charitywater/india-mark-ii-sensor/Firmware/ssm/doc/CapTIvate Harness.png

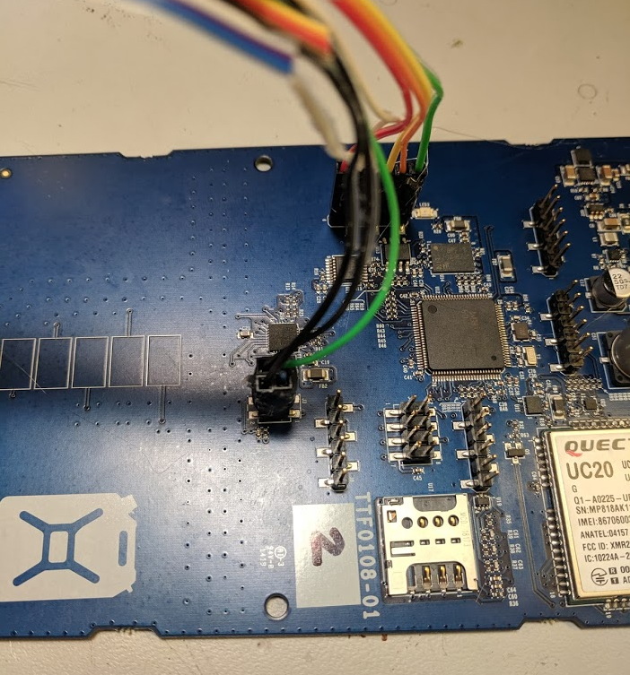
Firmware/ssm/doc/CapTIvate Harness.png
