charitywater/india-mark-ii-sensor/Mechanical/TT10723_ASM_SENSOR_REV-D.PDF

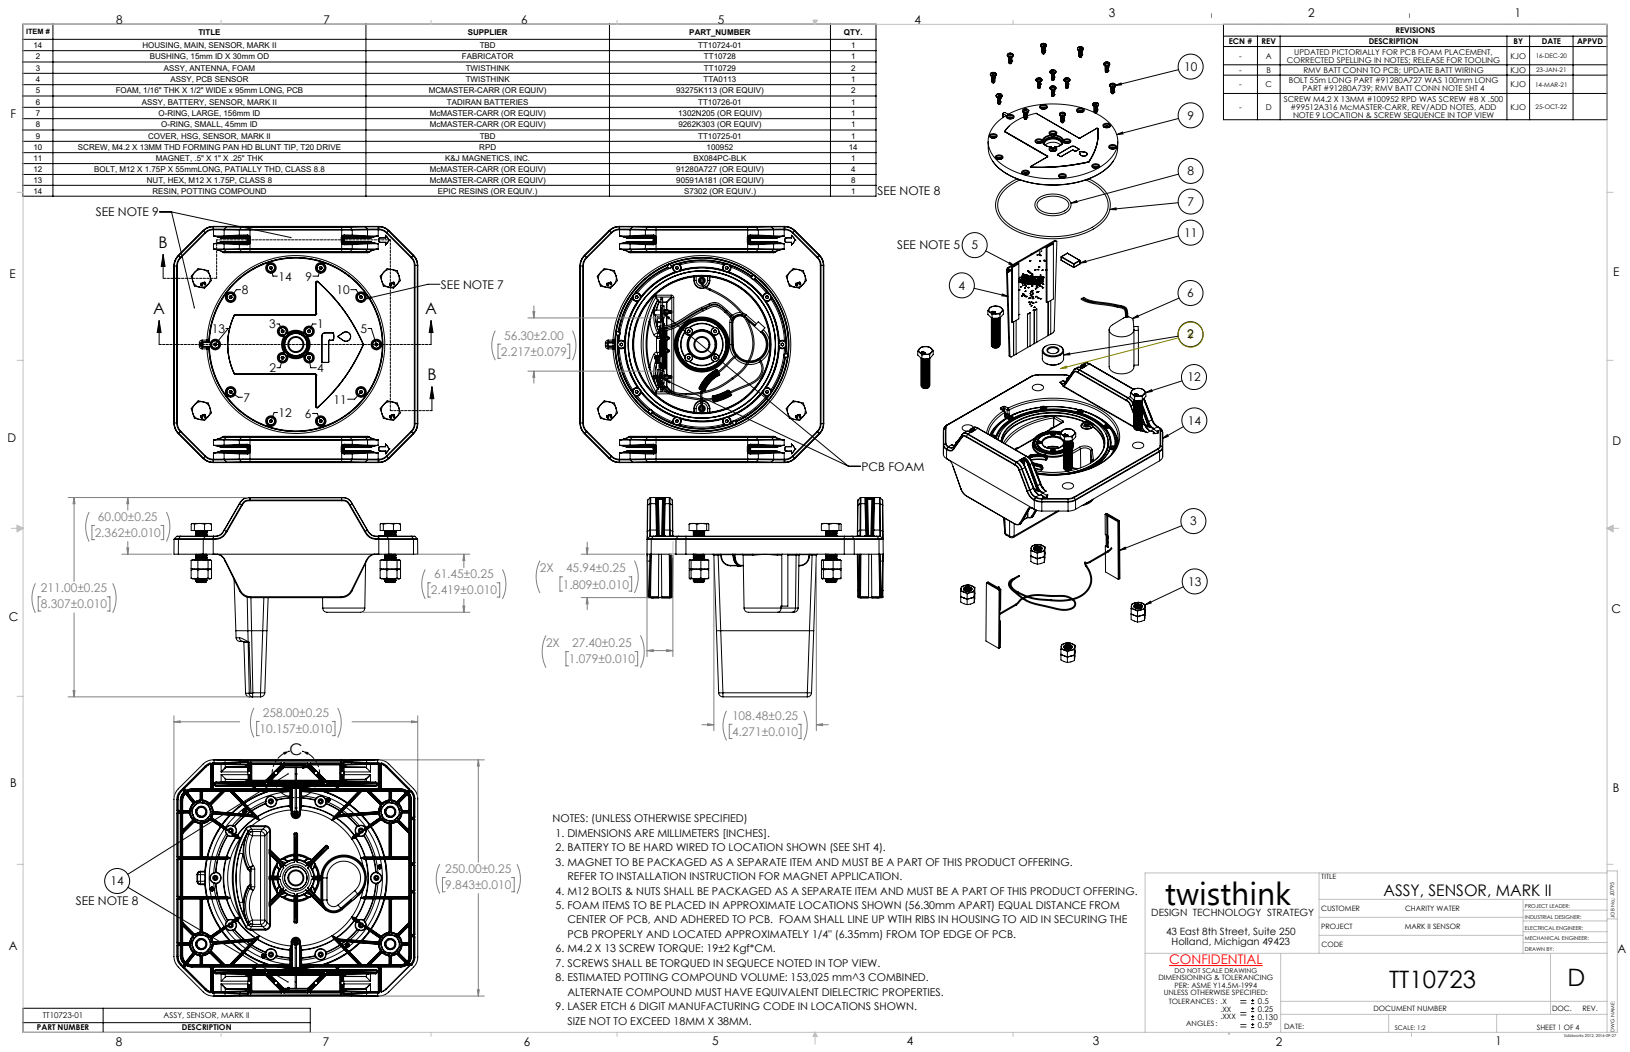
[picture p2: page 1]
SEE NOTE 5; SEE NOTE 7; SEE NOTE 9; PCB FOAM; SEE NOTE 8; ITEM #; TITLE; SUPPLIER; PART_NUMBER; QTY.; SCALE: 1:2; SHEET 1 OF 4; DRAWN BY:; CHARITY WATER; DOCUMENT NUMBER; DOC. REV.; MECHANICAL ENGINEER:; ELECTRICAL ENGINEER:; INDUSTRIAL DESIGNER:; PROJECT LEADER:; Solidworks 2012, 2016-09-27

ECN # | REV | DESCRIPTION | BY | DATE | APPVD
- | A | UPDATED PICTORIALLY FOR PCB FOAM PLACEMENT, CORRECTED SPELLING IN NOTES; RELEASE FOR TOOLING | KJO | 16-DEC-20
- | B | RMV BATT CONN TO PCB; UPDATE BATT WIRING | KJO | 23-JAN-21
- | C | BOLT 55m LONG PART #91280A727 WAS 100mm LONG PART #91280A739; RMV BATT CONN NOTE SHT 4 | KJO | 14-MAR-21
- D | | SCREW M4.2 X 13MM #100952 RPD WAS SCREW #8 X .500 #99512A316 McMASTER-CARR, REV/ADD NOTES, ADD NOTE 9 LOCATION & SCREW SEQUENCE IN TOP VIEW | KJO | 25-OCT-22

14 | HOUSING, MAIN, SENSOR, MARK II | TBD | TT10724-01 | 1
2 | BUSHING, 15mm ID X 30mm OD | FABRICATOR | TT10728 | 1
3 | ASSY, ANTENNA, FOAM | TWISTHINK | TT10729 | 2
4 | ASSY, PCB SENSOR | TWISTHINK | TTA0113 | 1
5 | FOAM, 1/16" THK X 1/2" WIDE x 95mm LONG, PCB | MCMASTER-CARR (OR EQUIV) | 93275K113 (OR EQUIV) | 2
6 | ASSY, BATTERY, SENSOR, MARK II | TADIRAN BATTERIES | TT10726-01 | 1
7 | O-RING, LARGE, 156mm ID | McMASTER-CARR (OR EQUIV) | 1302N205 (OR EQUIV) | 1
8 | O-RING, SMALL, 45mm ID | McMASTER-CARR (OR EQUIV) | 9262K303 (OR EQUIV) | 1
9 | COVER, HSG, SENSOR, MARK II | TBD | TT10725-01 | 1
10 | SCREW, M4.2 X 13MM THD FORMING PAN HD BLUNT TIP, T20 DRIVE | RPD | 100952 | 14
11 | MAGNET, .5" X 1" X .25" THK | K&J MAGNETICS, INC. | BX084PC-BLK | 1
12 | BOLT, M12 X 1.75P X 55mmLONG, PATIALLY THD, CLASS 8.8 | McMASTER-CARR (OR EQUIV) | 91280A727 (OR EQUIV) | 4
13 | NUT, HEX, M12 X 1.75P, CLASS 8 | McMASTER-CARR (OR EQUIV) | 90591A181 (OR EQUIV) | 8
14 | RESIN, POTTING COMPOUND | EPIC RESINS (OR EQUIV.) | S7302 (OR EQUIV.) | 1

NOTES: (UNLESS OTHERWISE SPECIFIED)
1. DIMENSIONS ARE MILLIMETERS [INCHES].
2. BATTERY TO BE HARD WIRED TO LOCATION SHOWN (SEE SHT 4).
3. MAGNET TO BE PACKAGED AS A SEPARATE ITEM AND MUST BE A PART OF THIS PRODUCT OFFERING.
REFER TO INSTALLATION INSTRUCTION FOR MAGNET APPLICATION.
4. M12 BOLTS & NUTS SHALL BE PACKAGED AS A SEPARATE ITEM AND MUST BE A PART OF THIS PRODUCT OFFERING.
5. FOAM ITEMS TO BE PLACED IN APPROXIMATE LOCATIONS SHOWN (56.30mm APART) EQUAL DISTANCE FROM
CENTER OF PCB, AND ADHERED TO PCB. FOAM SHALL LINE UP WTIH RIBS IN HOUSING TO AID IN SECURING THE
PCB PROPERLY AND LOCATED APPROXIMATELY 1/4" (6.35mm) FROM TOP EDGE OF PCB.
6. M4.2 X 13 SCREW TORQUE: 19±2 Kgf*CM.
7. SCREWS SHALL BE TORQUED IN SEQUECE NOTED IN TOP VIEW.
8. ESTIMATED POTTING COMPOUND VOLUME: 153,025 mm^3 COMBINED.
ALTERNATE COMPOUND MUST HAVE EQUIVALENT DIELECTRIC PROPERTIES.
9. LASER ETCH 6 DIGIT MANUFACTURING CODE IN LOCATIONS SHOWN.
SIZE NOT TO EXCEED 18MM X 38MM.

TITLE
ASSY, SENSOR, MARK II

DWG NAME: JOB No,:

DESIGN TECHNOLOGY STRATEGY
MARK II SENSOR 43 East 8th Street, Suite 250
Holland, Michigan 49423
CONFIDENTIAL
DO NOT SCALE DRAWING
DIMENSIONING & TOLERANCING
PER: ASME Y14.5M-1994
UNLESS OTHERWISE SPECIFIED:
TOLERANCES

TT10723-01 | ASSY, SENSOR, MARK II
PART NUMBER | DESCRIPTION

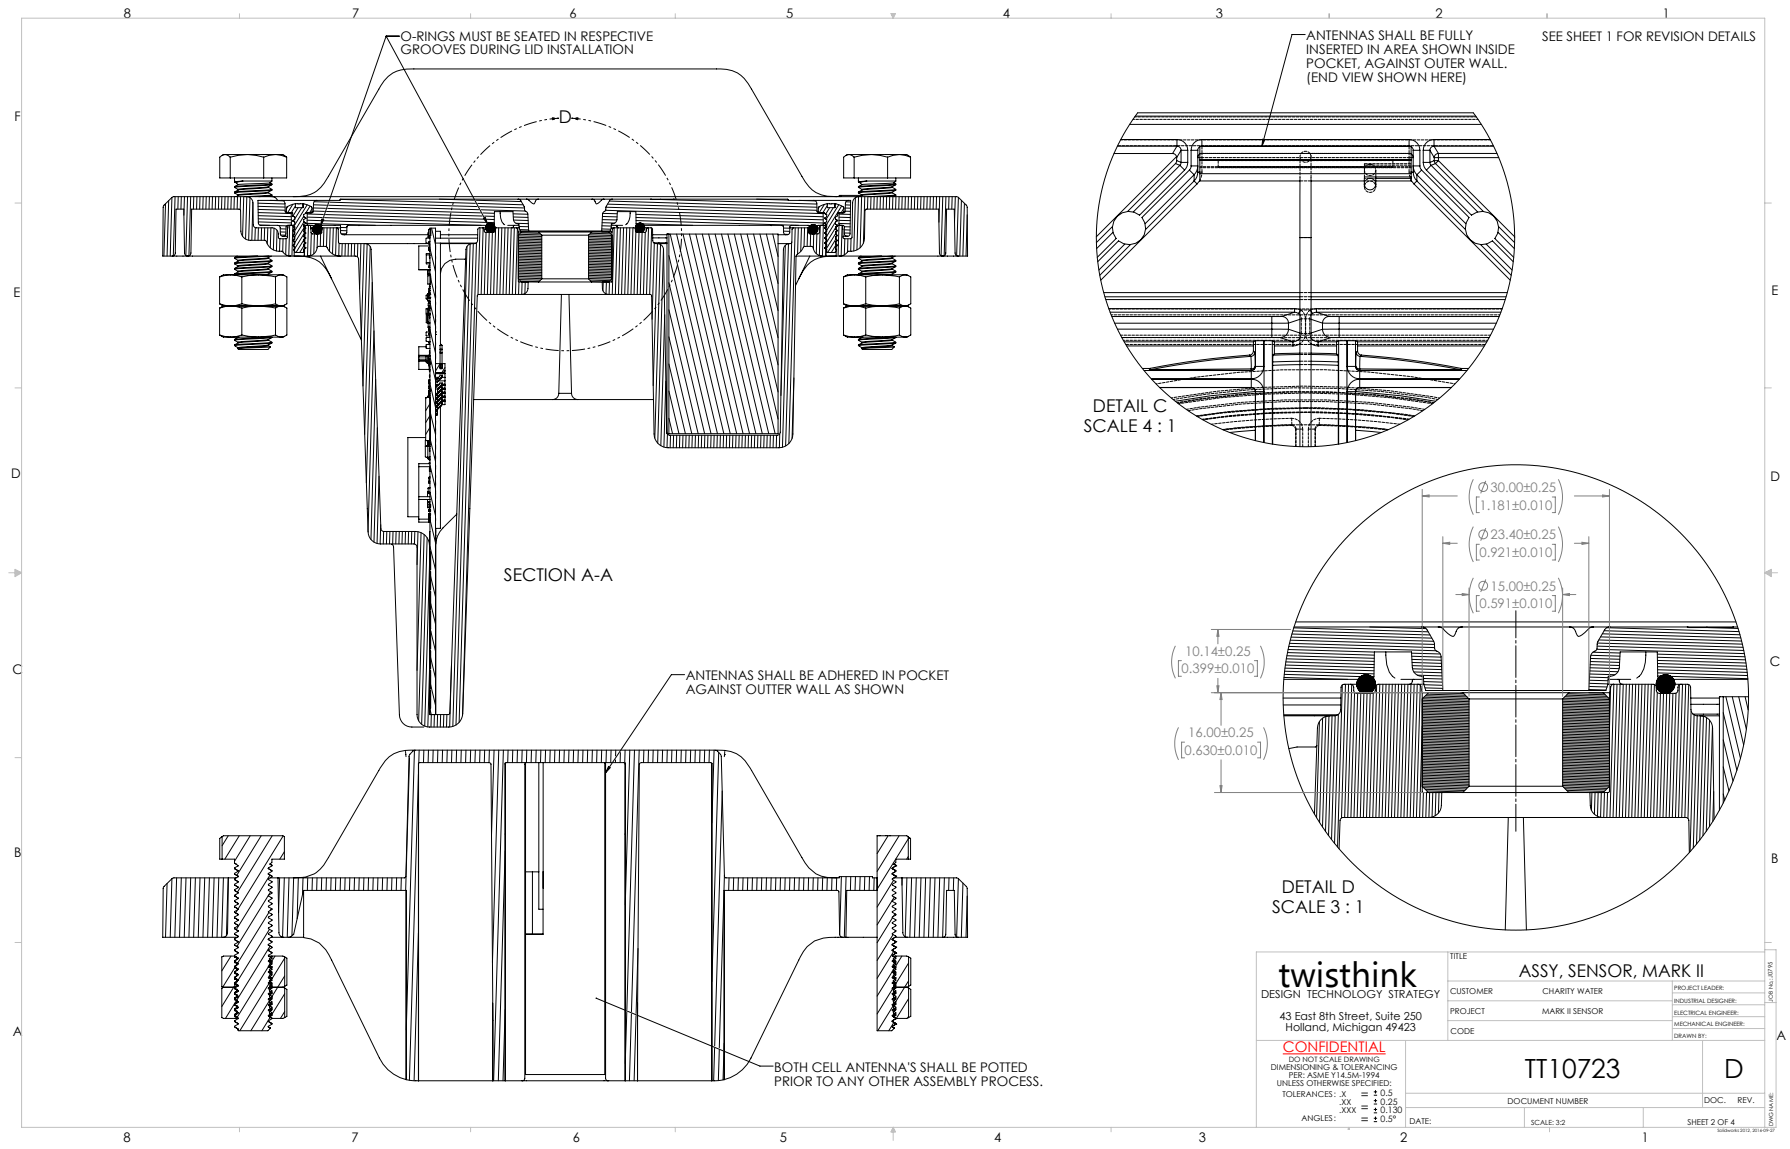
[picture p3: page 2]
SECTION A-A; DETAIL C SCALE 4 : 1; DETAIL D SCALE 3 : 1; SCALE: 3:2; DRAWN BY:; CHARITY WATER; MECHANICAL ENGINEER:; ELECTRICAL ENGINEER:; INDUSTRIAL DESIGNER:; PROJECT LEADER:

O-RINGS MUST BE SEATED IN RESPECTIVE
GROOVES DURING LID INSTALLATION

ANTENNAS SHALL BE FULLY
INSERTED IN AREA SHOWN INSIDE
POCKET, AGAINST OUTER WALL.
(END VIEW SHOWN HERE)

SEE SHEET 1 FOR REVISION DETAILS

ANTENNAS SHALL BE ADHERED IN POCKET
AGAINST OUTTER WALL AS SHOWN

TITLE
ASSY, SENSOR, MARK II

DWG NAME: JOB No,:

DESIGN TECHNOLOGY STRATEGY
MARK II SENSOR 43 East 8th Street, Suite 250
Holland, Michigan 49423
CONFIDENTIAL

BOTH CELL ANTENNA'S SHALL BE POTTED
PRIOR TO ANY OTHER ASSEMBLY PROCESS.

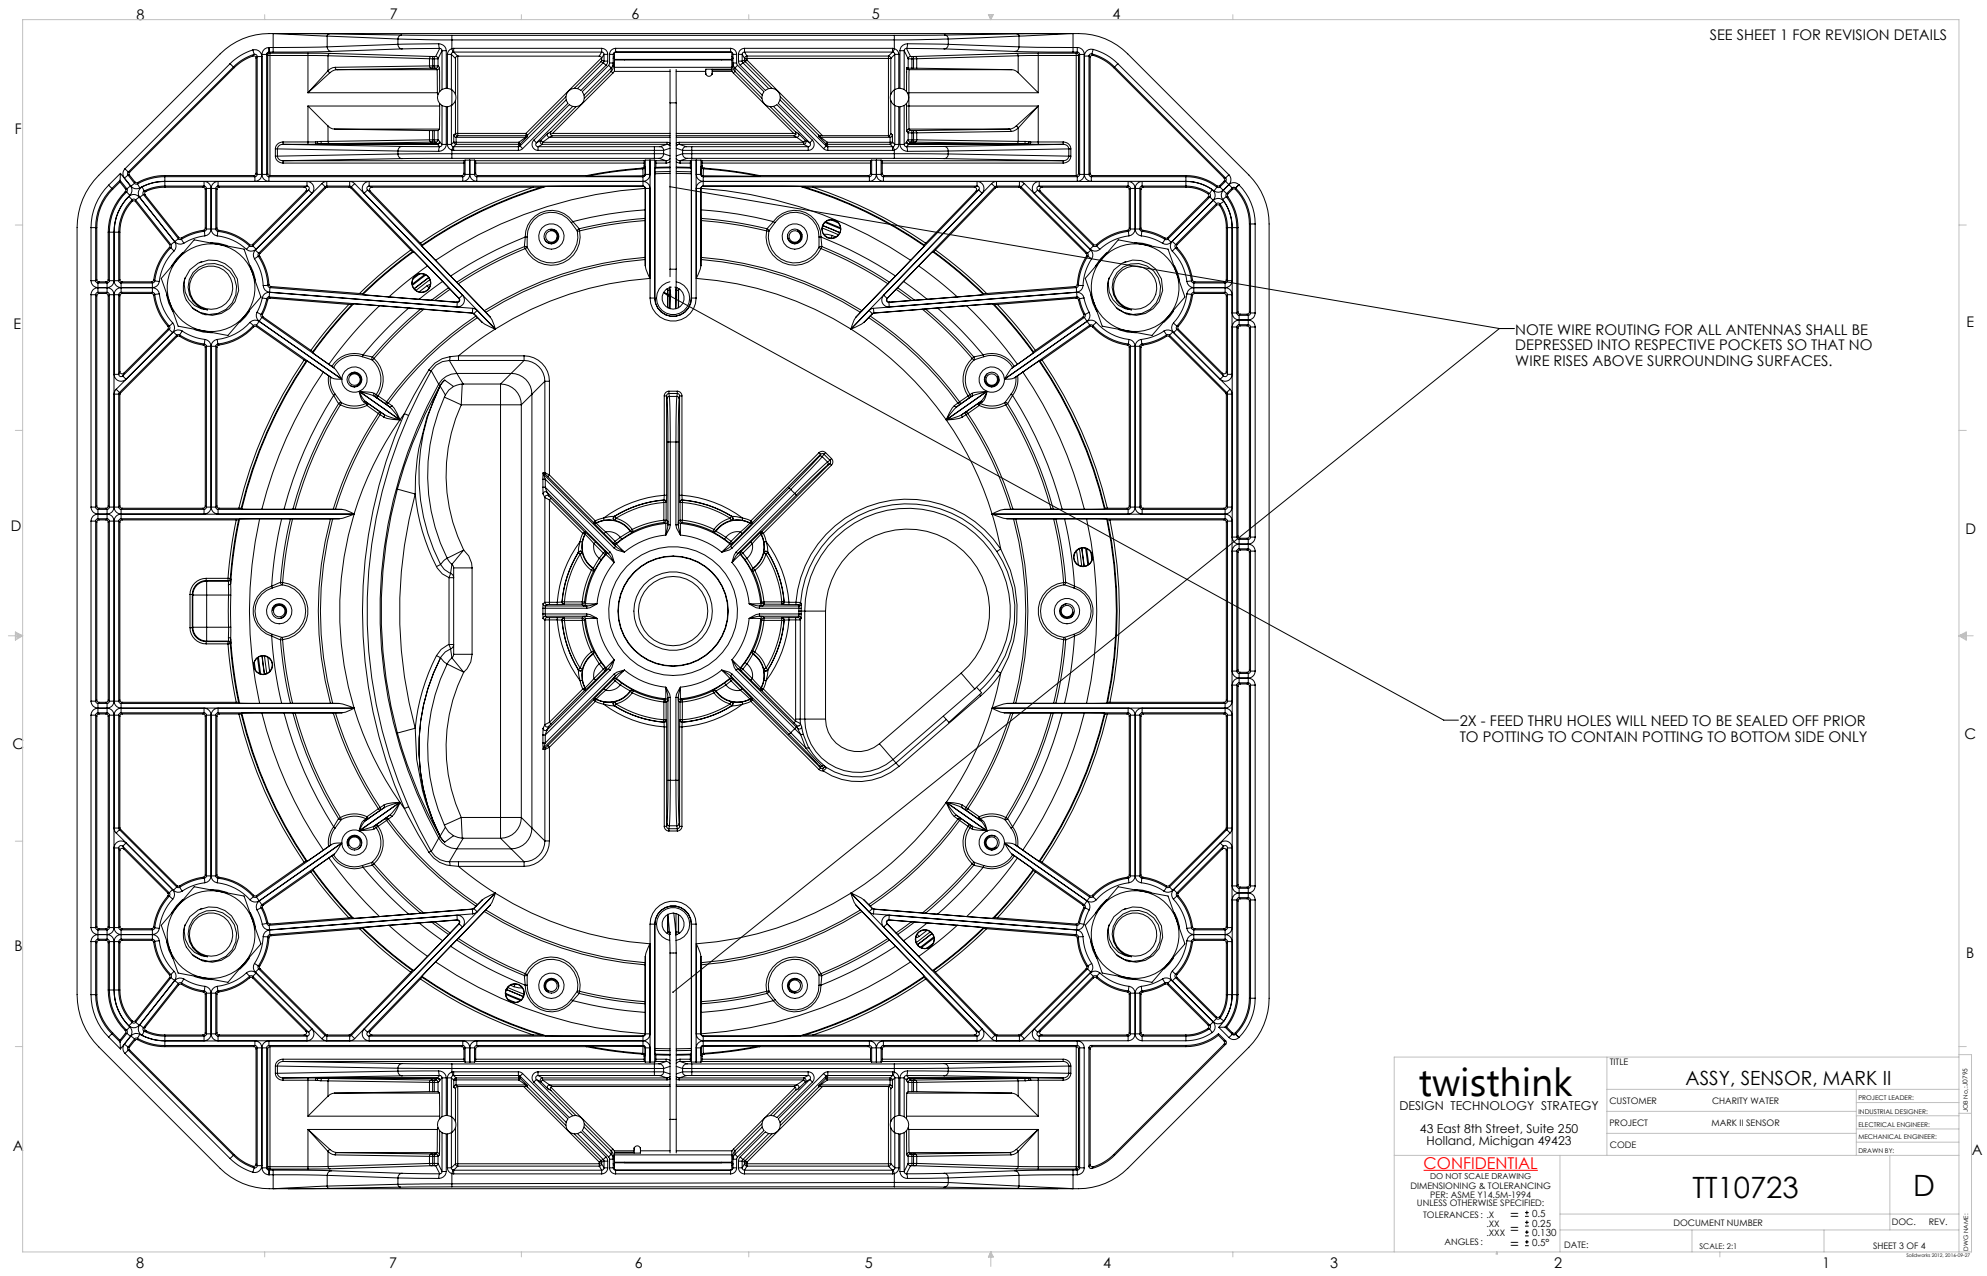
[picture p4: page 3]
SCALE: 2:1; DRAWN BY:; CHARITY WATER; MECHANICAL ENGINEER:; ELECTRICAL ENGINEER:; INDUSTRIAL DESIGNER:; PROJECT LEADER:

NOTE WIRE ROUTING FOR ALL ANTENNAS SHALL BE
DEPRESSED INTO RESPECTIVE POCKETS SO THAT NO
WIRE RISES ABOVE SURROUNDING SURFACES.

2X - FEED THRU HOLES WILL NEED TO BE SEALED OFF PRIOR
TO POTTING TO CONTAIN POTTING TO BOTTOM SIDE ONLY

TITLE
ASSY, SENSOR, MARK II

DWG NAME: JOB No,:

DESIGN TECHNOLOGY STRATEGY
MARK II SENSOR 43 East 8th Street, Suite 250
Holland, Michigan 49423
CONFIDENTIAL

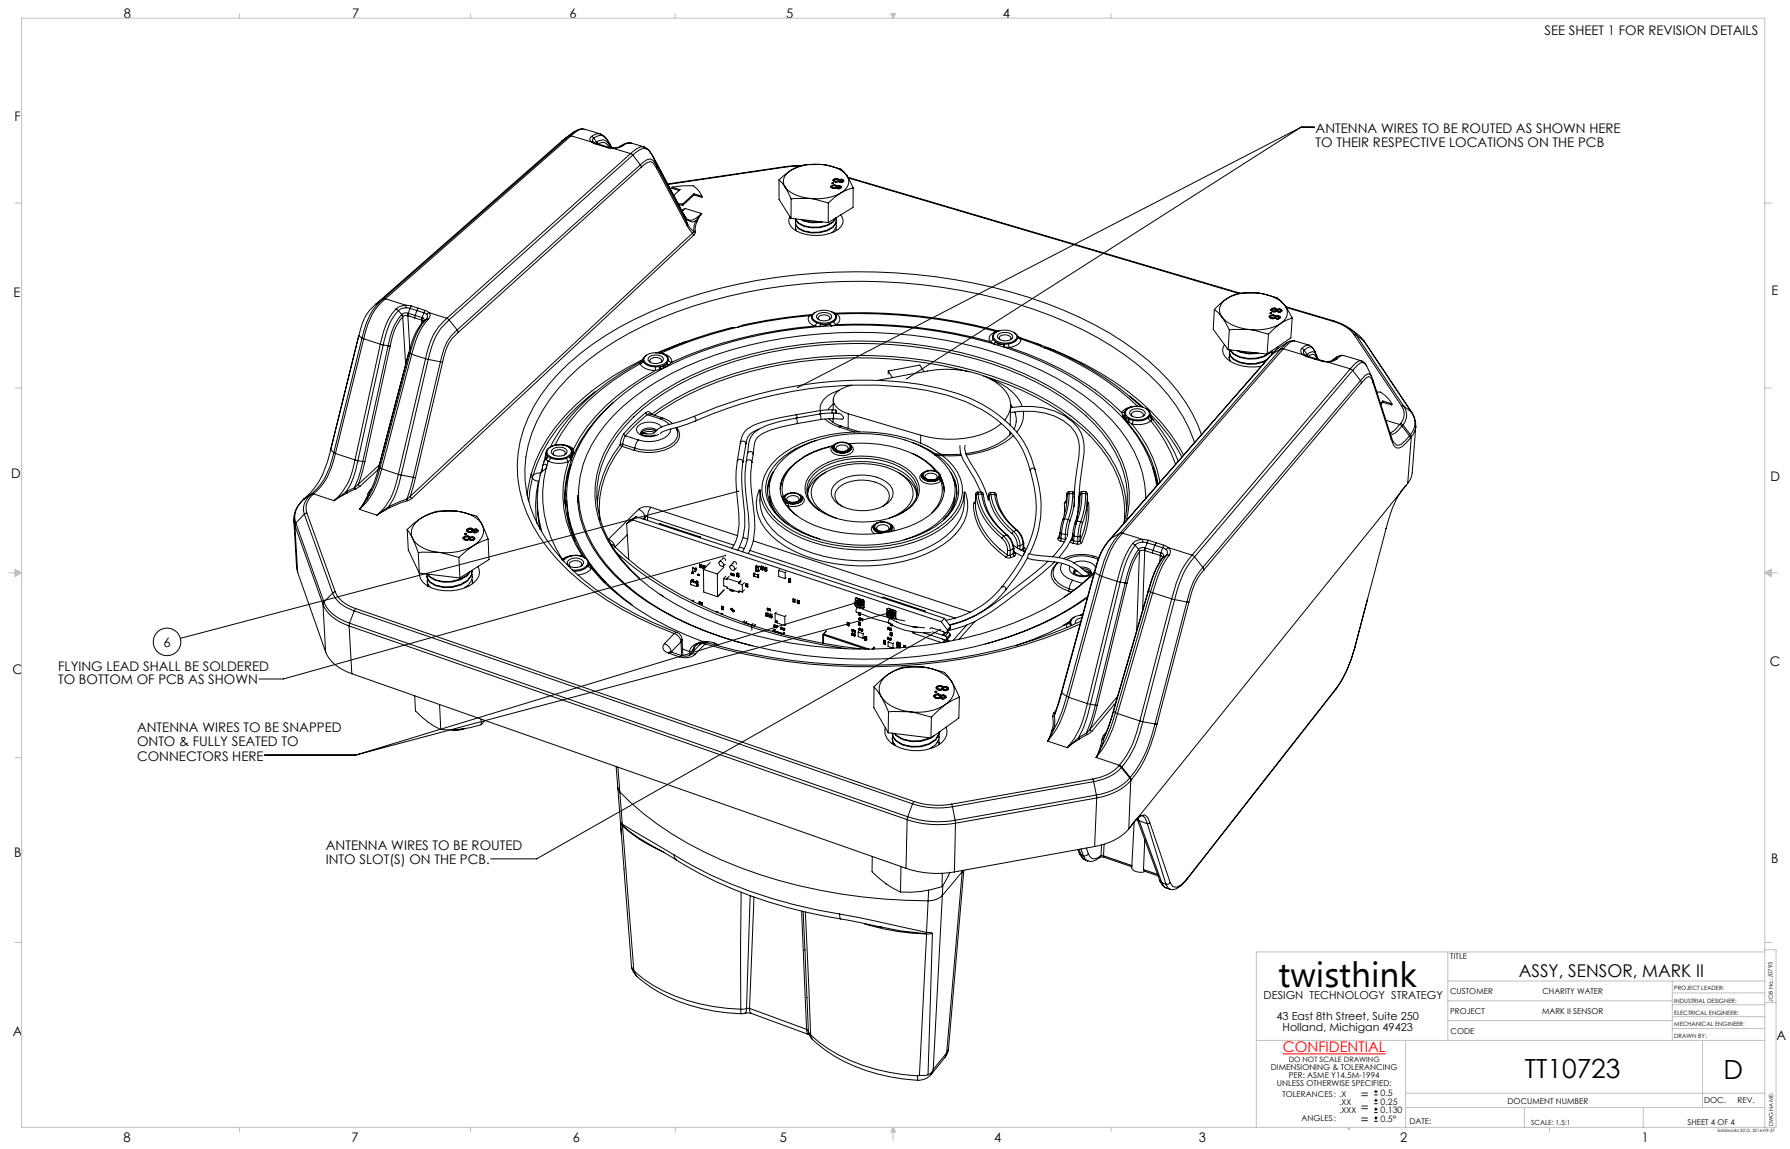
[picture p5: page 4]
SCALE: 1.5:1; DRAWN BY:; CHARITY WATER; MECHANICAL ENGINEER:; ELECTRICAL ENGINEER:; INDUSTRIAL DESIGNER:; PROJECT LEADER:

ANTENNA WIRES TO BE ROUTED AS SHOWN HERE
TO THEIR RESPECTIVE LOCATIONS ON THE PCB

FLYING LEAD SHALL BE SOLDERED
TO BOTTOM OF PCB AS SHOWN

ANTENNA WIRES TO BE SNAPPED
ONTO & FULLY SEATED TO
CONNECTORS HERE

ANTENNA WIRES TO BE ROUTED
INTO SLOT(S) ON THE PCB.

TITLE
ASSY, SENSOR, MARK II

DWG NAME: JOB No,:

DESIGN TECHNOLOGY STRATEGY
MARK II SENSOR 43 East 8th Street, Suite 250
Holland, Michigan 49423
CONFIDENTIAL
