charitywater/india-mark-ii-sensor/Mechanical/TT10724_hsg_main_REV-C.PDF

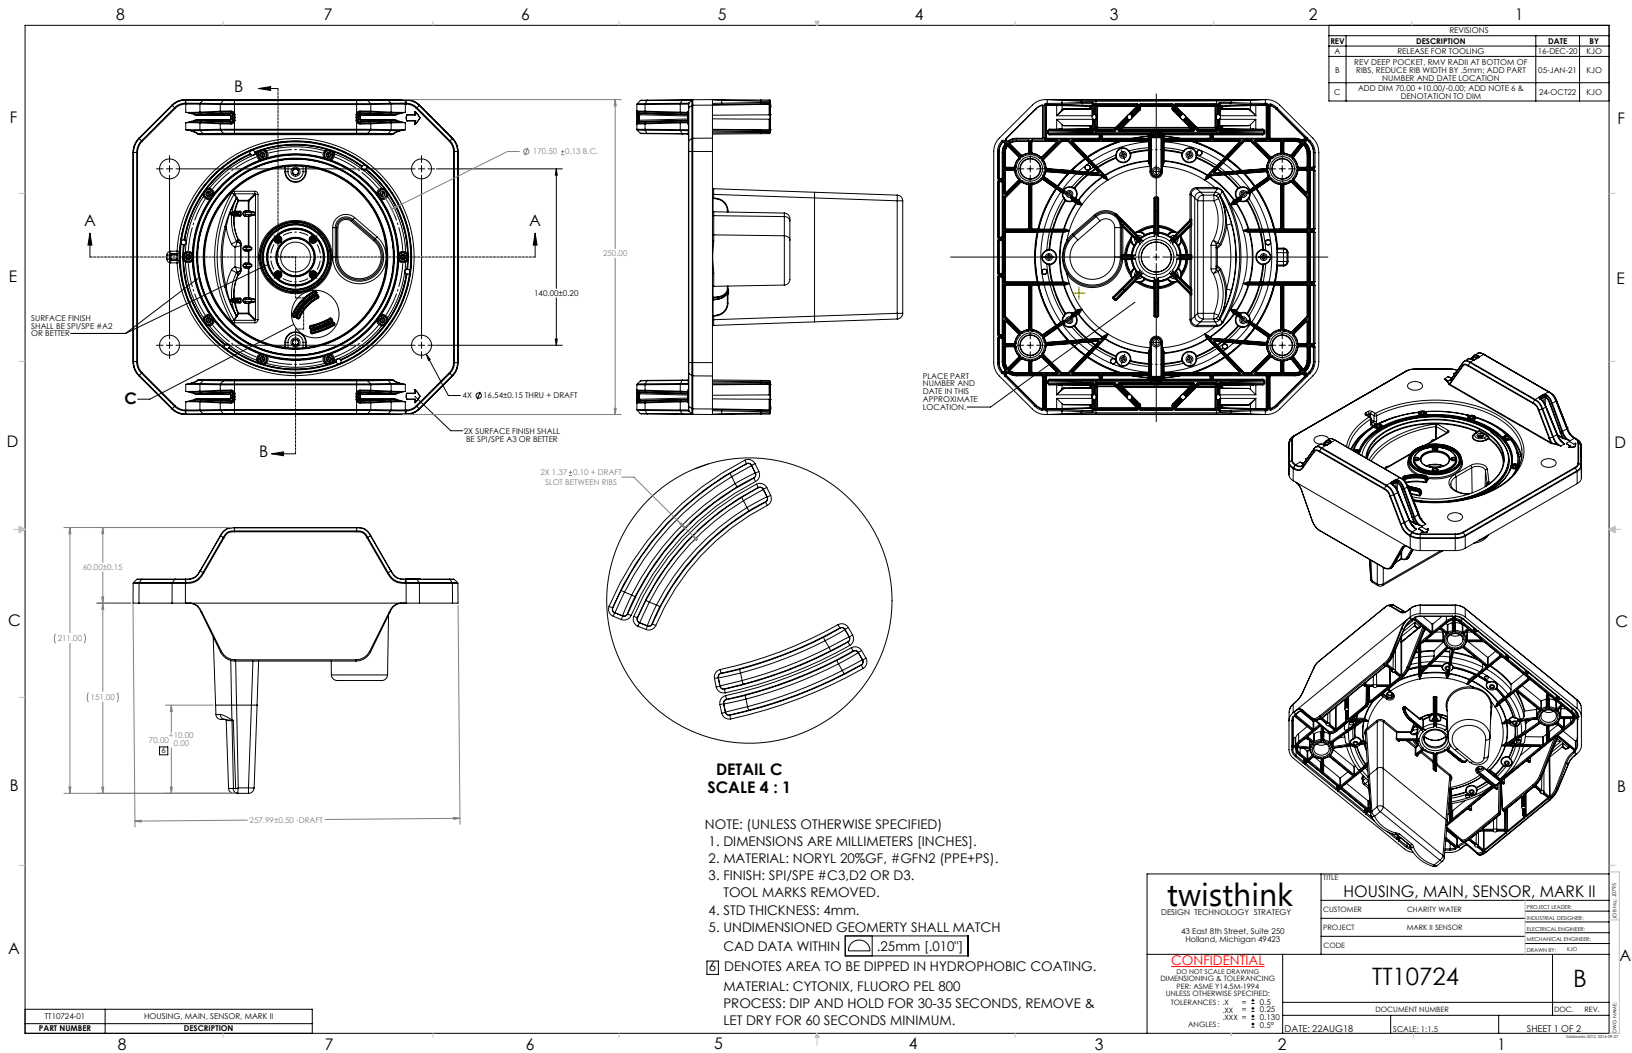
[picture p6: page 1]
257.99±0.50 -DRAFT; 4X 16.54±0.15 THRU + DRAFT; 0.10 + DRAFT; DETAIL C SCALE 4 : 1; CAD DATA WITHIN; DENOTES AREA TO BE DIPPED IN HYDROPHOBIC COATING.; DRAWN BY:; CHARITY WATER; MECHANICAL ENGINEER:; ELECTRICAL ENGINEER:; INDUSTRIAL DESIGNER:; PROJECT LEADER:; Solidworks 2012, 2016-09-27

REVISIONS

REV | DESCRIPTION | DATE | BY
A | RELEASE FOR TOOLING | 16-DEC-20 | KJO
B | REV DEEP POCKET, RMV RADII AT BOTTOM OF RIBS, REDUCE RIB WIDTH BY .5mm; ADD PART NUMBER AND DATE LOCATION | 05-JAN-21 | KJO

C | ADD DIM 70.00 +10.00/-0.00; ADD NOTE 6 & DENOTATION TO DIM | 24-OCT22 | KJO

SURFACE FINISH
SHALL BE SPI/SPE #A2
OR BETTER

PLACE PART
NUMBER AND
DATE IN THIS
APPROXIMATE
LOCATION.

2X SURFACE FINISH SHALL
BE SPI/SPE A3 OR BETTER

SLOT BETWEEN RIBS

NOTE: (UNLESS OTHERWISE SPECIFIED)
1. DIMENSIONS ARE MILLIMETERS [INCHES].
2. MATERIAL: NORYL 20%GF, #GFN2 (PPE+PS).
3. FINISH: SPI/SPE #C3,D2 OR D3.
TOOL MARKS REMOVED.
4. STD THICKNESS: 4mm.
5. UNDIMENSIONED GEOMERTY SHALL MATCH
MATERIAL: CYTONIX, FLUORO PEL 800
PROCESS: DIP AND HOLD FOR 30-35 SECONDS, REMOVE &
LET DRY FOR 60 SECONDS MINIMUM.

TITLE
HOUSING, MAIN, SENSOR, MARK II

DWG NAME: JOB No,:

DESIGN TECHNOLOGY STRATEGY
MARK II SENSOR 43 East 8th Street, Suite 250
Holland, Michigan 49423
CONFIDENTIAL
DO NOT SCALE DRAWING
DIMENSIONING & TOLERANCING
PER: ASME Y14.5M-1994
UNLESS OTHERWISE SPECIFIED:
TOLERANCES

DOCUMENT NUMBER | DOC. REV.

TT10724-01 | HOUSING, MAIN, SENSOR, MARK II
PART NUMBER | DESCRIPTION

DATE: 22AUG18 | SCALE: 1:1.5 | SHEET 1 OF 2

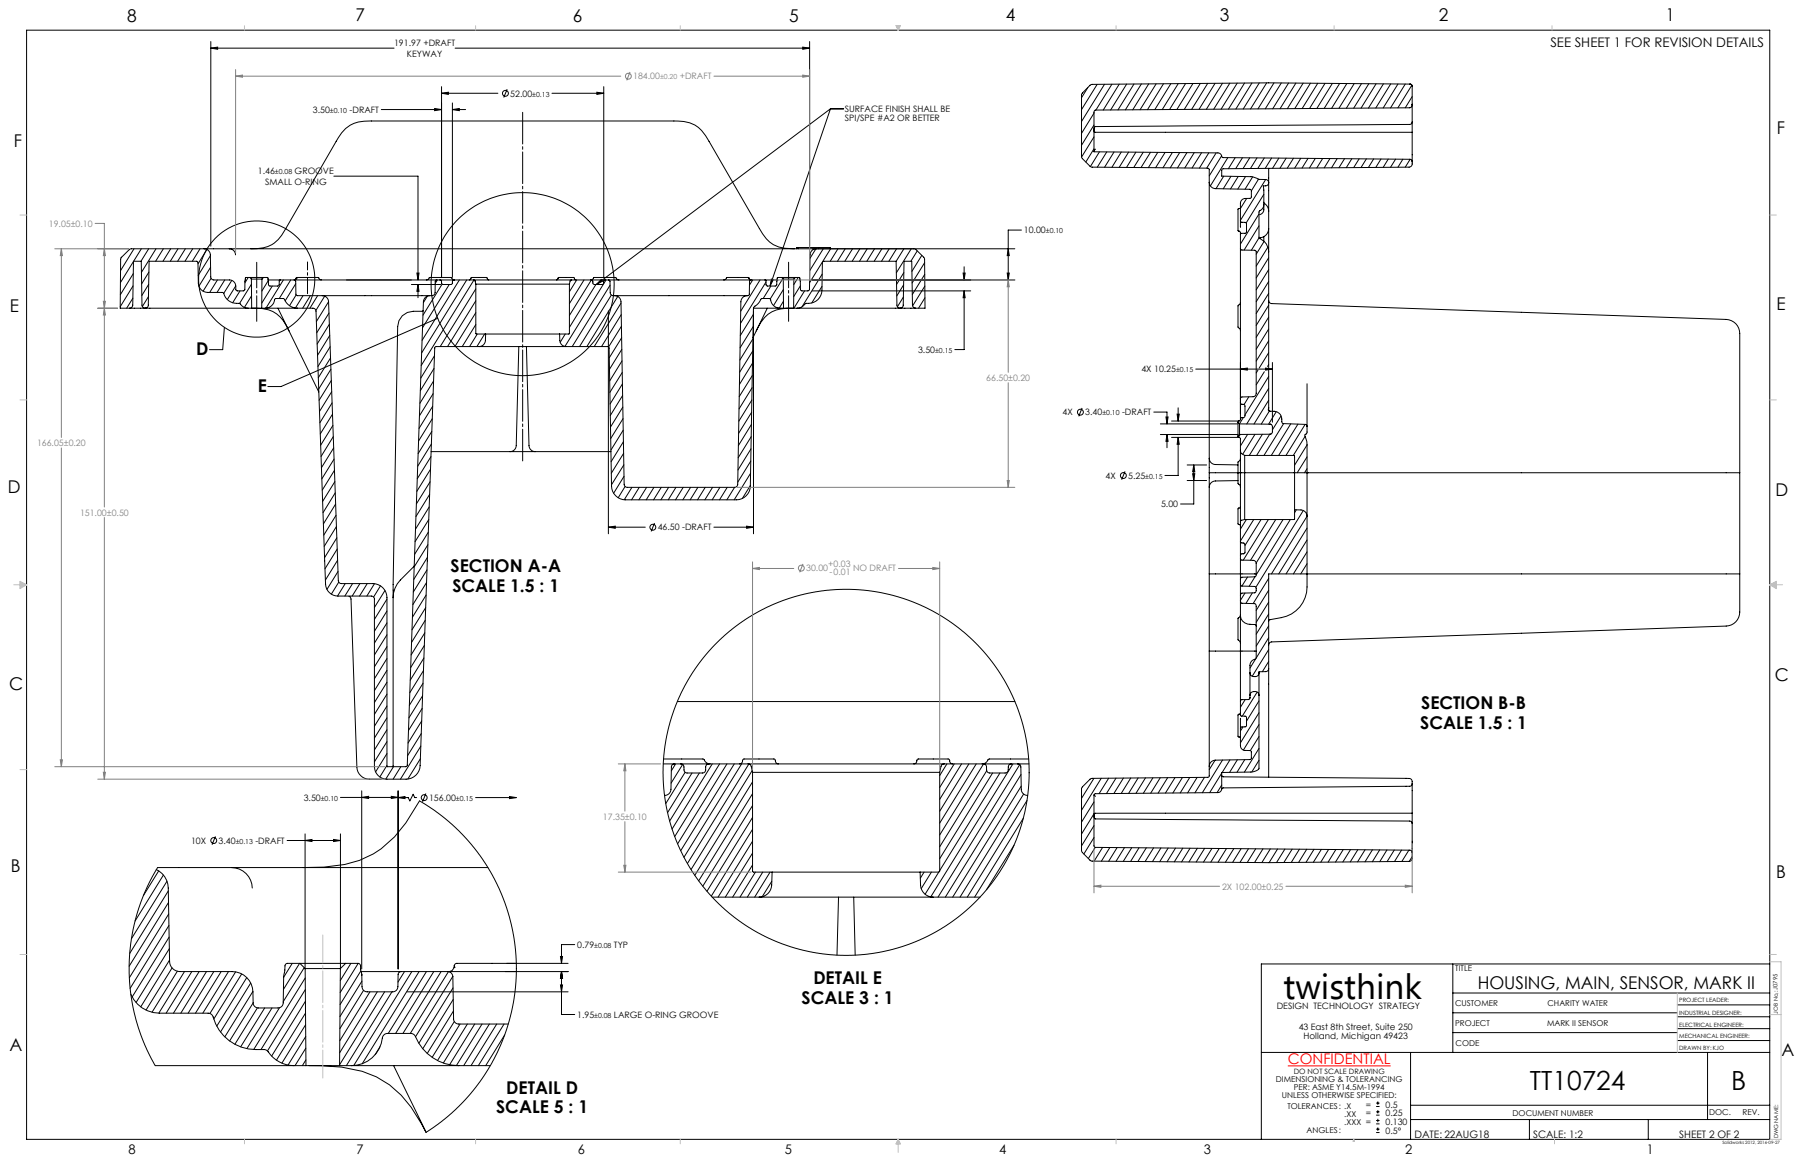
[picture p7: page 2]
4X 3.40±0.10 -DRAFT; SECTION B-B SCALE 1.5 : 1; 46.50 -DRAFT; 3.50±0.10 -DRAFT; 1.46±0.08 GROOVE SMALL O-RING; 184.00±0.20 +DRAFT; 191.97 +DRAFT; SECTION A-A SCALE 1.5 : 1; 0.79±0.08 TYP; 10X 3.40±0.13 -DRAFT; DETAIL D SCALE 5 : 1; 0.01 NO DRAFT; DETAIL E SCALE 3 : 1; DRAWN BY:; CHARITY WATER; MECHANICAL ENGINEER:; ELECTRICAL ENGINEER:; INDUSTRIAL DESIGNER:; PROJECT LEADER:; Solidworks 2012, 2016-09-27

SEE SHEET 1 FOR REVISION DETAILS

SURFACE FINISH SHALL BE
SPI/SPE #A2 OR BETTER

TITLE
HOUSING, MAIN, SENSOR, MARK II

DWG NAME: JOB No,:

DESIGN TECHNOLOGY STRATEGY
MARK II SENSOR 43 East 8th Street, Suite 250
Holland, Michigan 49423

1.95±0.08 LARGE O-RING GROOVE

CONFIDENTIAL DO NOT SCALE DRAWING DIMENSIONING & TOLERANCING PER: ASME Y14.5M-1994 UNLESS OTHERWISE SPECIFIED: TOLERANCES : .X | TT10724 | B

DOCUMENT NUMBER | DOC. REV.

DATE: 22AUG18 | SCALE: 1:2 | SHEET 2 OF 2
