charitywater/india-mark-ii-sensor/Mechanical/TT10728_bushing_REV-B.PDF

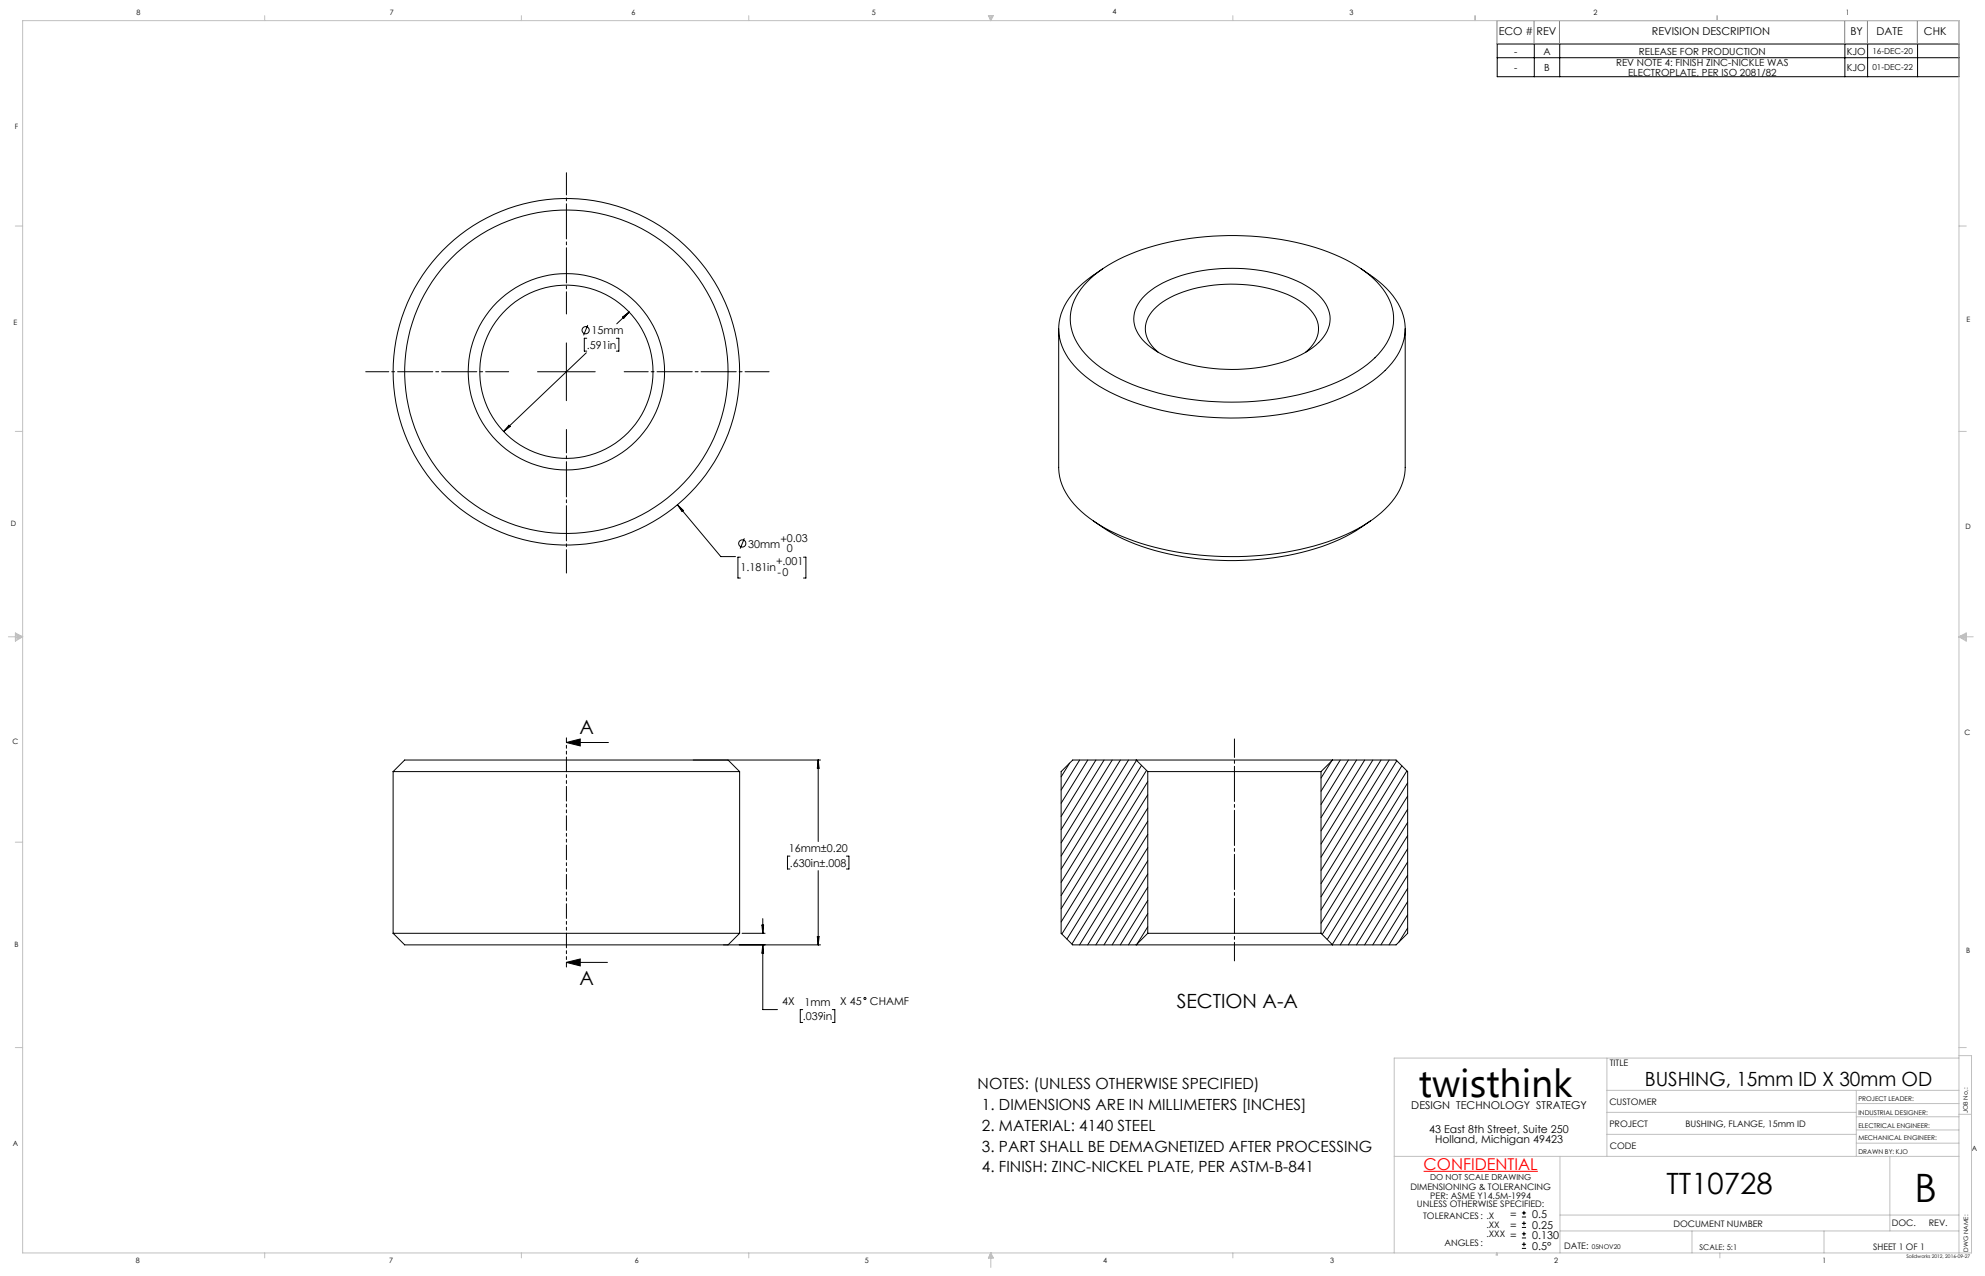
[picture p8: page 1]
X 45 CHAMF; SECTION A-A; SCALE: 5:1; SHEET 1 OF 1; DRAWN BY:; DOCUMENT NUMBER; DOC. REV.; MECHANICAL ENGINEER:; ELECTRICAL ENGINEER:; INDUSTRIAL DESIGNER:; PROJECT LEADER:; Solidworks 2012, 2016-09-27

ECO # REV | | REVISION DESCRIPTION | BY | DATE | CHK
- | A | RELEASE FOR PRODUCTION | KJO | 16-DEC-20
- | B | REV NOTE 4: FINISH ZINC-NICKLE WAS ELECTROPLATE, PER ISO 2081/82 | KJO | 01-DEC-22

TITLE
BUSHING, 15mm ID X 30mm OD

NOTES: (UNLESS OTHERWISE SPECIFIED)
1. DIMENSIONS ARE IN MILLIMETERS [INCHES]
2. MATERIAL: 4140 STEEL
3. PART SHALL BE DEMAGNETIZED AFTER PROCESSING
4. FINISH: ZINC-NICKEL PLATE, PER ASTM-B-841

DWG NAME: JOB No,:

DESIGN TECHNOLOGY STRATEGY
BUSHING, FLANGE, 15mm ID 43 East 8th Street, Suite 250
Holland, Michigan 49423
CONFIDENTIAL
DO NOT SCALE DRAWING
DIMENSIONING & TOLERANCING
PER: ASME Y14.5M-1994
UNLESS OTHERWISE SPECIFIED:
TOLERANCES
