charitywater/india-mark-ii-sensor/Mechanical/TT10725_hsg_cover_REV-B.PDF

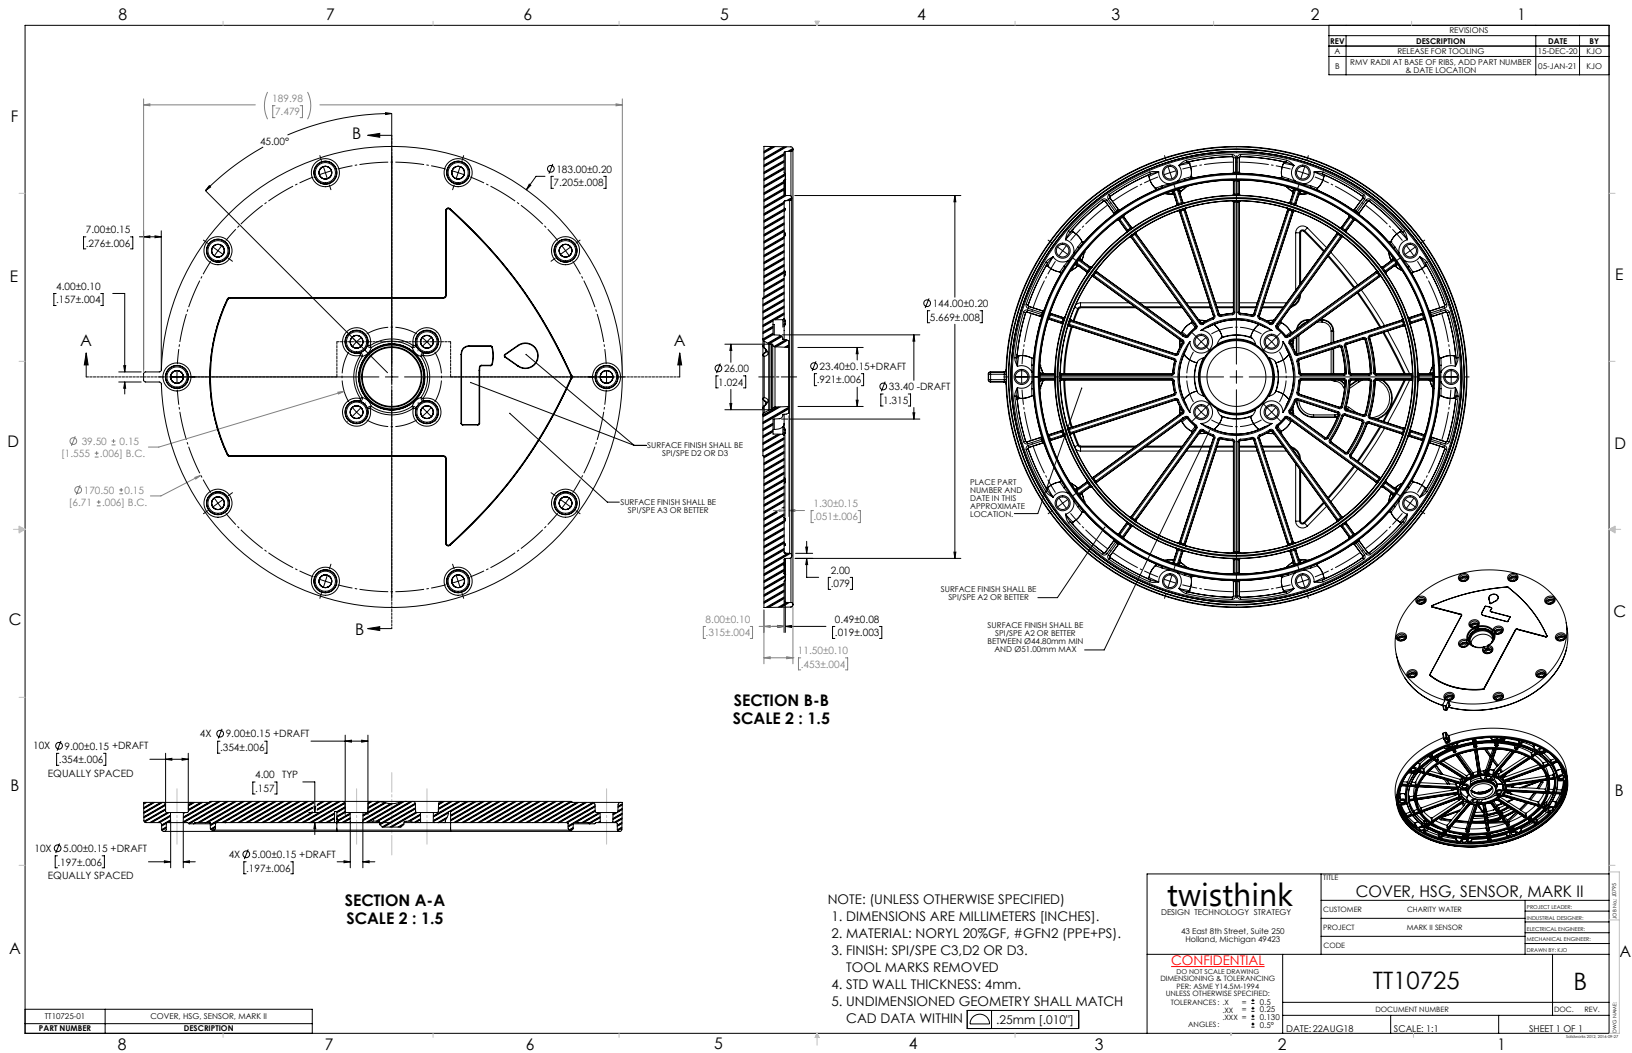
[picture p9: page 1]
EQUALLY SPACED; SECTION A-A SCALE 2 : 1.5; SECTION B-B SCALE 2 : 1.5; COVER, HSG, SENSOR, MARK II; DRAWN BY:; MECHANICAL ENGINEER:; ELECTRICAL ENGINEER:; INDUSTRIAL DESIGNER:; Solidworks 2012, 2016-09-27

B | REVISIONS

REV | DESCRIPTION | DATE | BY
A | RELEASE FOR TOOLING | 15-DEC-20 | KJO
B | RMV RADII AT BASE OF RIBS, ADD PART NUMBER & DATE LOCATION | 05-JAN-21 | KJO

SURFACE FINISH SHALL BE
SPI/SPE D2 OR D3

PLACE PART
NUMBER AND
DATE IN THIS
APPROXIMATE
LOCATION.

SPI/SPE A3 OR BETTER

SPI/SPE A2 OR BETTER

BETWEEN Ø44.80mm MIN
AND Ø51.00mm MAX

twisthink DESIGN TECHNOLOGY STRATEGY Holland, Michigan 49423 | TITLE COVER, HSG, SENSOR, MARK II

NOTE: (UNLESS OTHERWISE SPECIFIED)
1. DIMENSIONS ARE MILLIMETERS [INCHES].
2. MATERIAL: NORYL 20%GF, #GFN2 (PPE+PS).
3. FINISH: SPI/SPE C3,D2 OR D3.
TOOL MARKS REMOVED
4. STD WALL THICKNESS: 4mm.
5. UNDIMENSIONED GEOMETRY SHALL MATCH
CAD DATA WITHIN

DWG NAME: JOB No,:

CUSTOMER CHARITY WATER | PROJECT LEADER:

MARK II SENSOR 43 East 8th Street, Suite 250

CONFIDENTIAL DO NOT SCALE DRAWING DIMENSIONING & TOLERANCING PER: ASME Y14.5M-1994 UNLESS OTHERWISE SPECIFIED: TOLERANCES : .X | TT10725 | B

DOCUMENT NUMBER | DOC. REV.

PART NUMBER | DESCRIPTION

DATE: 22AUG18 | SCALE: 1:1 | SHEET 1 OF 1
