charitywater/india-mark-ii-sensor/Mechanical/TT10726_asm_batt_modified_REV-A.PDF

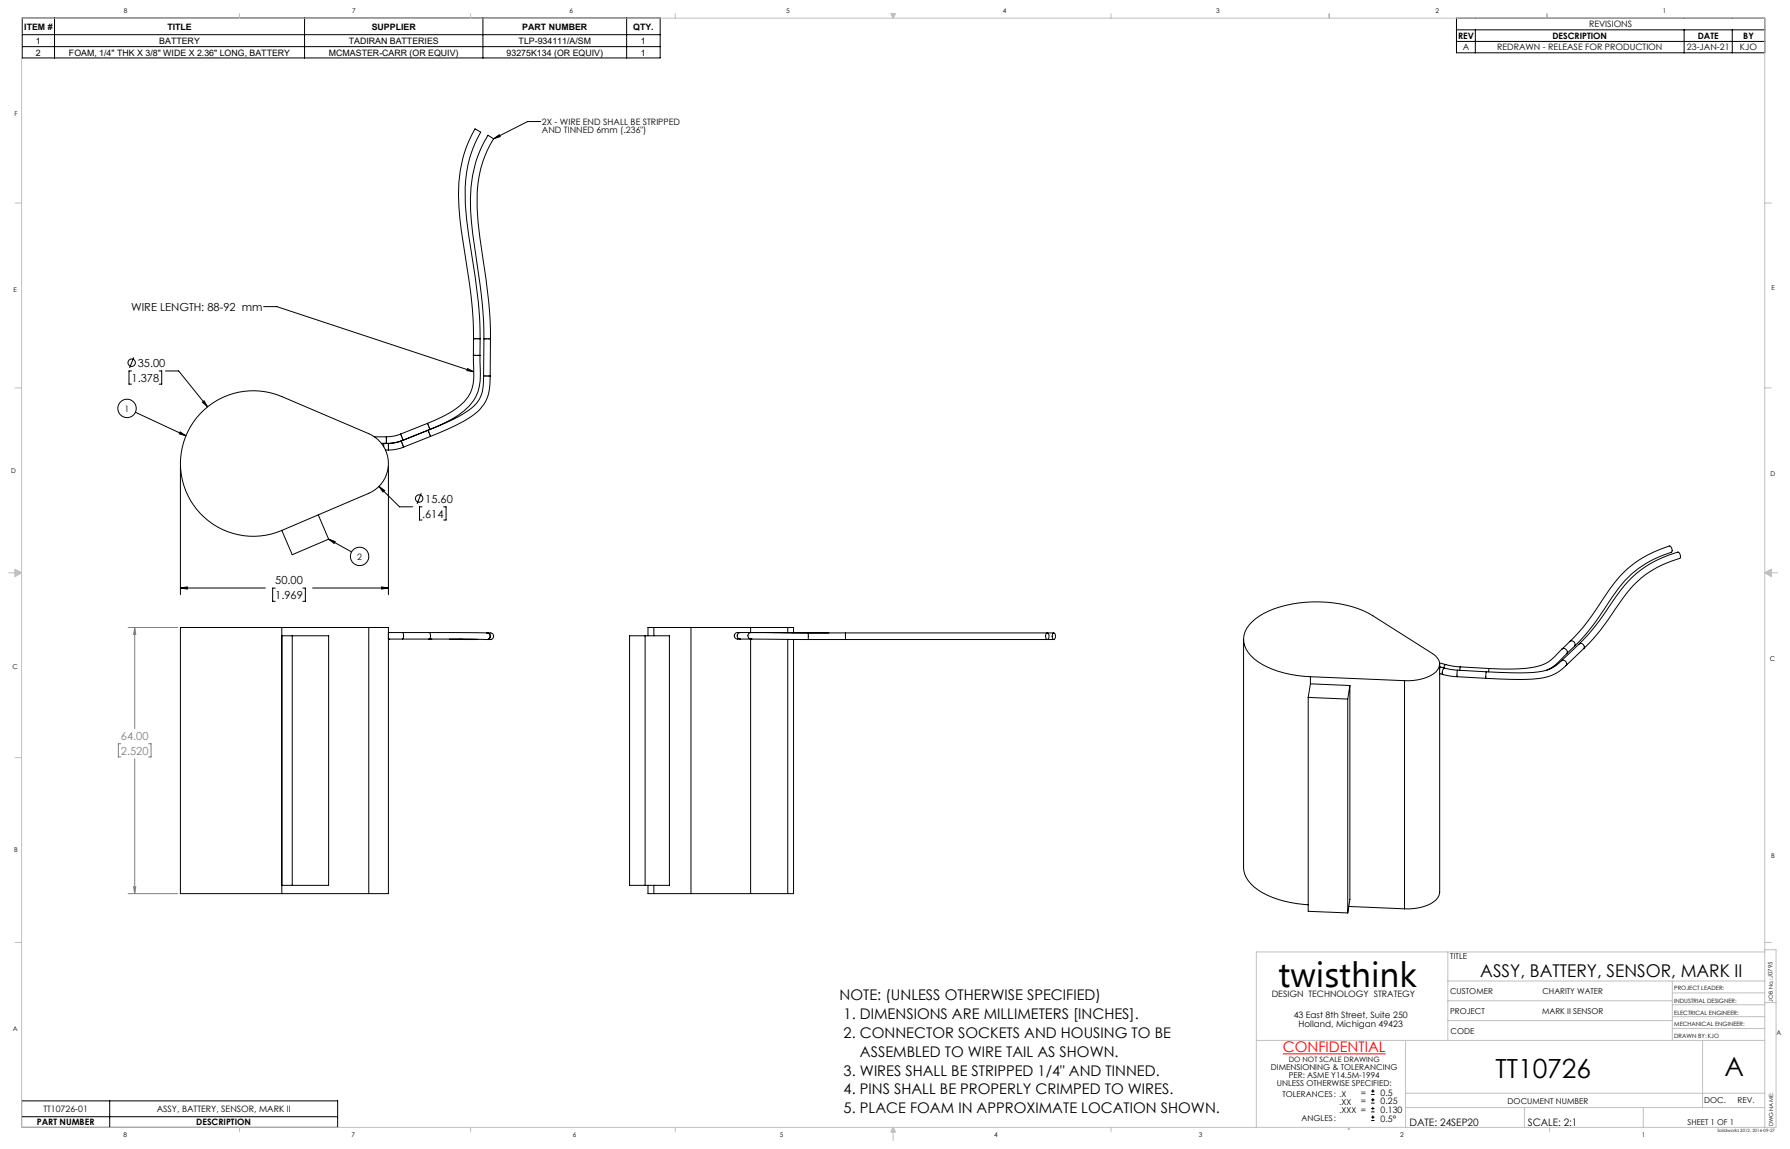
[picture p10: page 1]
ITEM #; TITLE; SUPPLIER; PART NUMBER; QTY.; SCALE: 2:1; SHEET 1 OF 1; DRAWN BY:; CHARITY WATER; DOCUMENT NUMBER; DOC. REV.; MECHANICAL ENGINEER:; ELECTRICAL ENGINEER:; INDUSTRIAL DESIGNER:; PROJECT LEADER:; Solidworks 2012, 2016-09-27

REV | DESCRIPTION | DATE | BY
A | REDRAWN - RELEASE FOR PRODUCTION | 23-JAN-21 | KJO

1 | BATTERY | TADIRAN BATTERIES | TLP-934111/A/SM | 1
2 | FOAM, 1/4" THK X 3/8" WIDE X 2.36" LONG, BATTERY | MCMASTER-CARR (OR EQUIV) | 93275K134 (OR EQUIV) | 1

2X - WIRE END SHALL BE STRIPPED
AND TINNED 6mm (.236")

WIRE LENGTH: 88-92 mm

TITLE
ASSY, BATTERY, SENSOR, MARK II

DWG NAME: JOB No,:

NOTE: (UNLESS OTHERWISE SPECIFIED)
1. DIMENSIONS ARE MILLIMETERS [INCHES].
2. CONNECTOR SOCKETS AND HOUSING TO BE
ASSEMBLED TO WIRE TAIL AS SHOWN.
3. WIRES SHALL BE STRIPPED 1/4" AND TINNED.
4. PINS SHALL BE PROPERLY CRIMPED TO WIRES.
5. PLACE FOAM IN APPROXIMATE LOCATION SHOWN.

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

TT10726-01 | ASSY, BATTERY, SENSOR, MARK II
PART NUMBER | DESCRIPTION
