charitywater/india-mark-ii-sensor/Mechanical/TT10729_asm_antenna_foam_REV-1.PDF

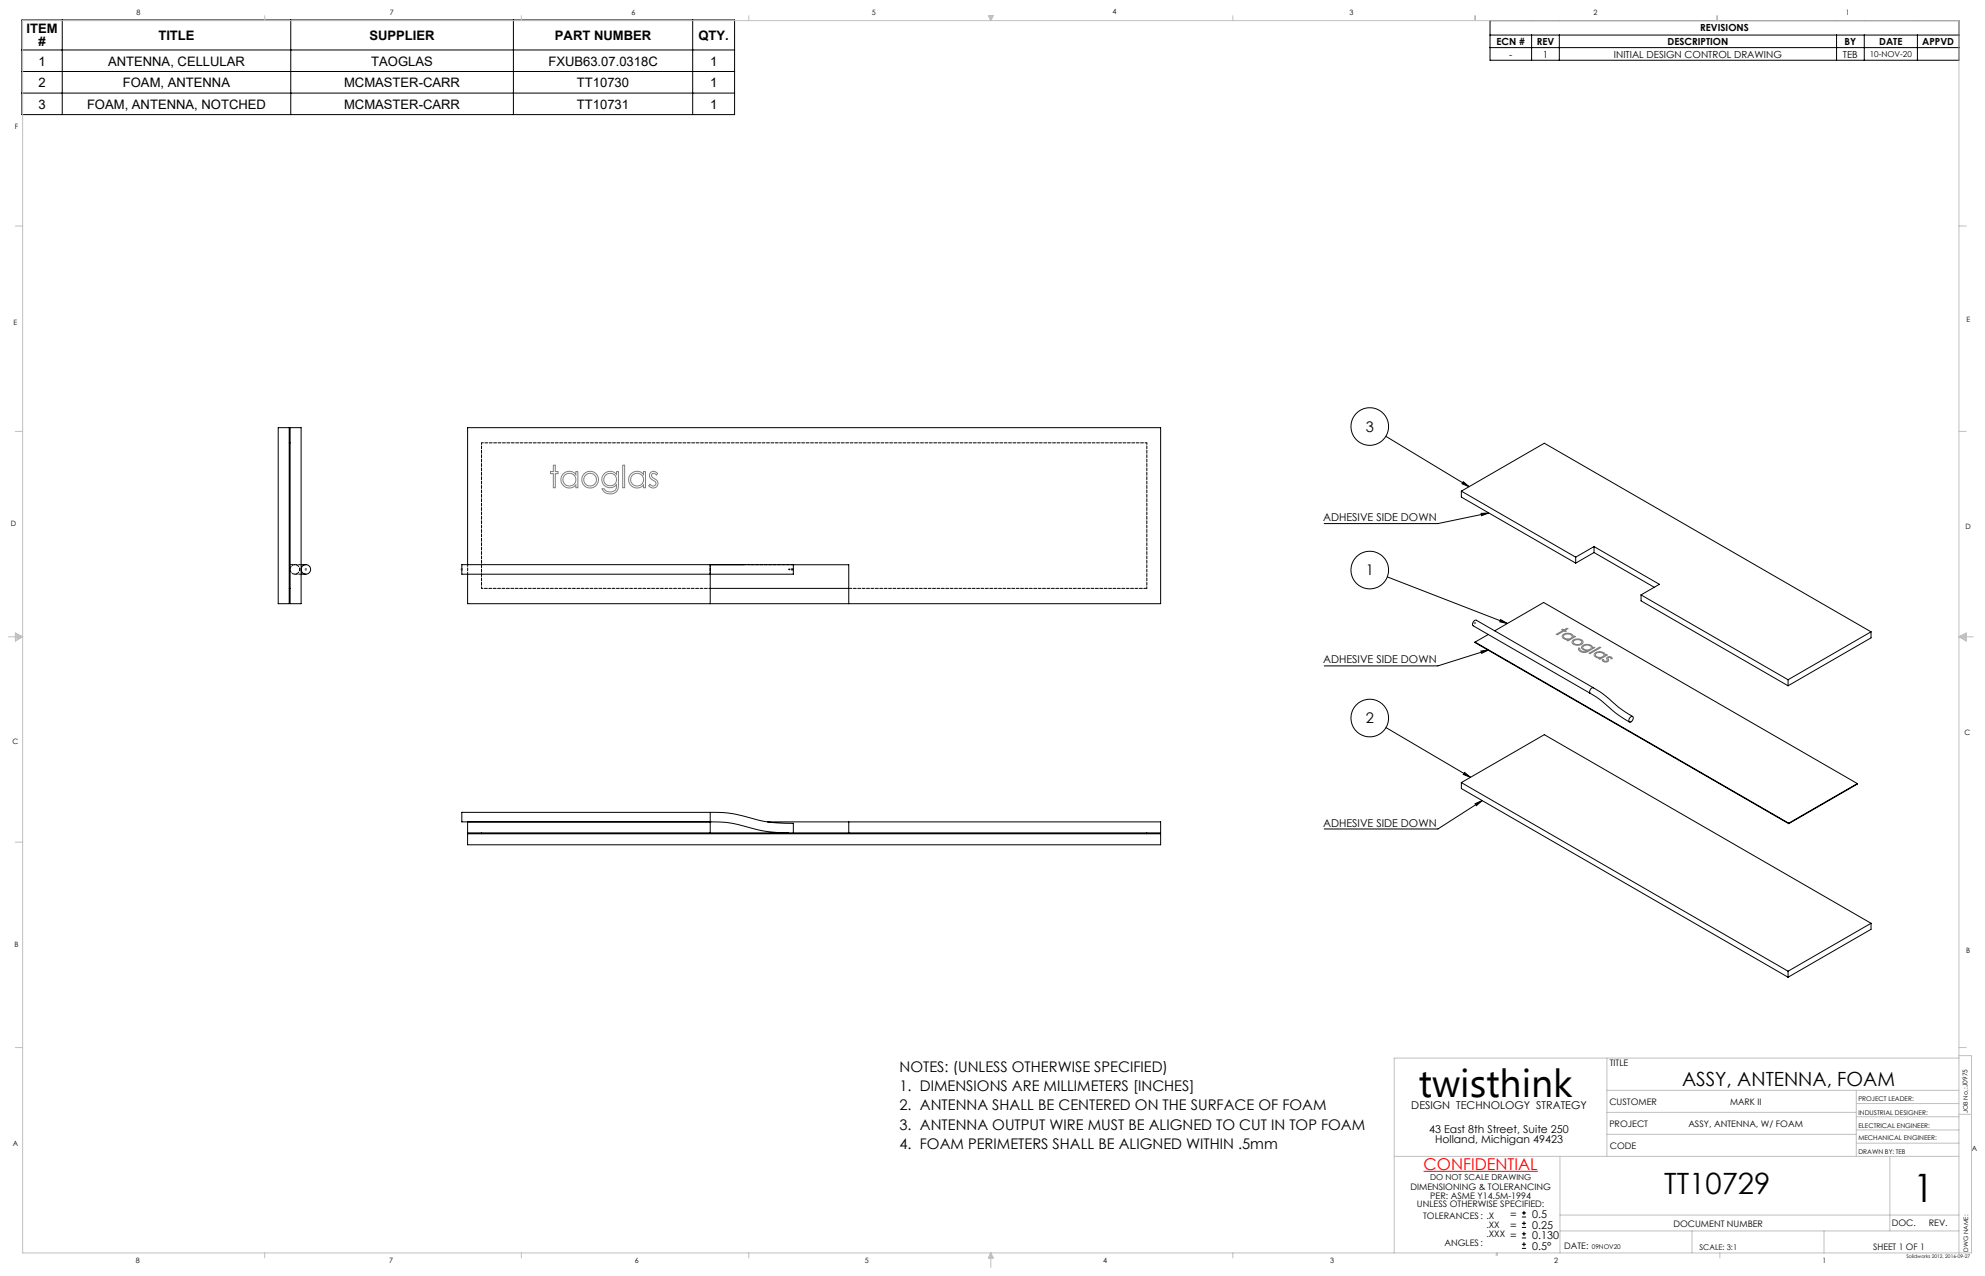
[picture p11: page 1]
TITLE; SUPPLIER; PART NUMBER; QTY.; ANTENNA, CELLULAR; TAOGLAS; FXUB63.07.0318C; ECN #; REV; DESCRIPTION; DATE; APPVD; INITIAL DESIGN CONTROL DRAWING; TEB; 10-NOV-20; SCALE: 3:1; SHEET 1 OF 1; DRAWN BY:; MARK II; DOCUMENT NUMBER; DOC. REV.; MECHANICAL ENGINEER:; ELECTRICAL ENGINEER:; INDUSTRIAL DESIGNER:; PROJECT LEADER:; Solidworks 2012, 2016-09-27

2 | FOAM, ANTENNA | MCMASTER-CARR | TT10730 | 1
3 | FOAM, ANTENNA, NOTCHED | MCMASTER-CARR | TT10731 | 1

ADHESIVE SIDE DOWN

NOTES: (UNLESS OTHERWISE SPECIFIED)
1. DIMENSIONS ARE MILLIMETERS [INCHES]
2. ANTENNA SHALL BE CENTERED ON THE SURFACE OF FOAM
3. ANTENNA OUTPUT WIRE MUST BE ALIGNED TO CUT IN TOP FOAM
4. FOAM PERIMETERS SHALL BE ALIGNED WITHIN .5mm

TITLE
ASSY, ANTENNA, FOAM

DWG NAME: JOB No,:

DESIGN TECHNOLOGY STRATEGY
ASSY, ANTENNA, W/ FOAM 43 East 8th Street, Suite 250
Holland, Michigan 49423
CONFIDENTIAL
DO NOT SCALE DRAWING
DIMENSIONING & TOLERANCING
PER: ASME Y14.5M-1994
UNLESS OTHERWISE SPECIFIED:
TOLERANCES
