charitywater/india-mark-ii-sensor/Mechanical/TT10730_antenna_foam_REV-1.PDF

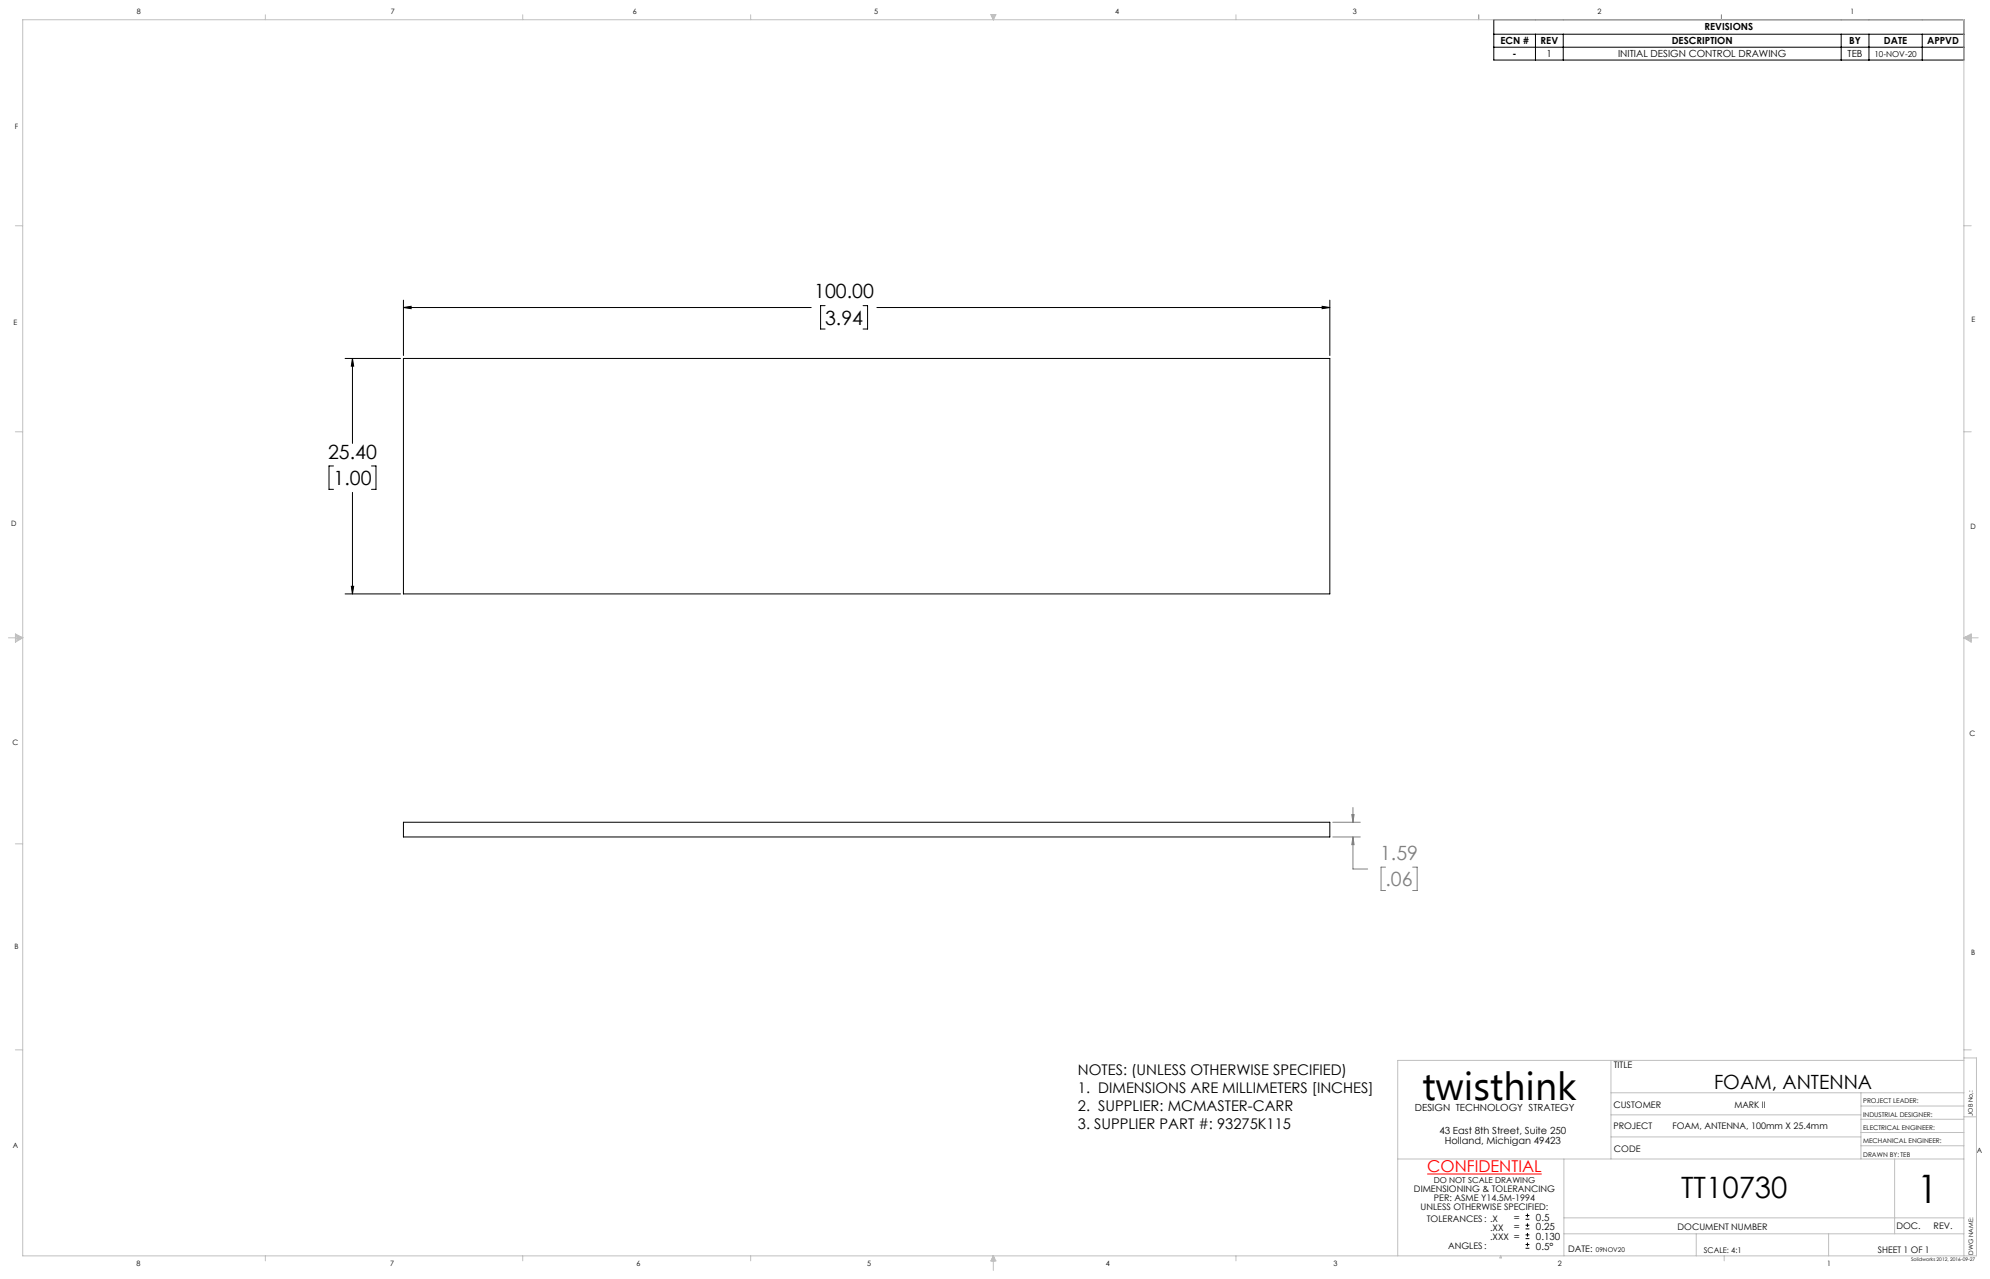
[picture p12: page 1]
SCALE: 4:1; FOAM, ANTENNA; SHEET 1 OF 1; DRAWN BY:; MARK II; DOCUMENT NUMBER; DOC. REV.; MECHANICAL ENGINEER:; ELECTRICAL ENGINEER:; INDUSTRIAL DESIGNER:; PROJECT LEADER:; Solidworks 2012, 2016-09-27

ECN # | REV | DESCRIPTION | BY | DATE | APPVD
- | 1 | INITIAL DESIGN CONTROL DRAWING | TEB | 10-NOV-20

NOTES: (UNLESS OTHERWISE SPECIFIED)
1. DIMENSIONS ARE MILLIMETERS [INCHES]
2. SUPPLIER: MCMASTER-CARR
3. SUPPLIER PART #: 93275K115

DWG NAME: JOB No,:

DESIGN TECHNOLOGY STRATEGY
FOAM, ANTENNA, 100mm X 25.4mm 43 East 8th Street, Suite 250
Holland, Michigan 49423
CONFIDENTIAL
DO NOT SCALE DRAWING
DIMENSIONING & TOLERANCING
PER: ASME Y14.5M-1994
UNLESS OTHERWISE SPECIFIED:
TOLERANCES
