charitywater/india-mark-ii-sensor/Electrical/TTS0108-05.pdf

# DC - DC CONVERTER

# PAGE 1

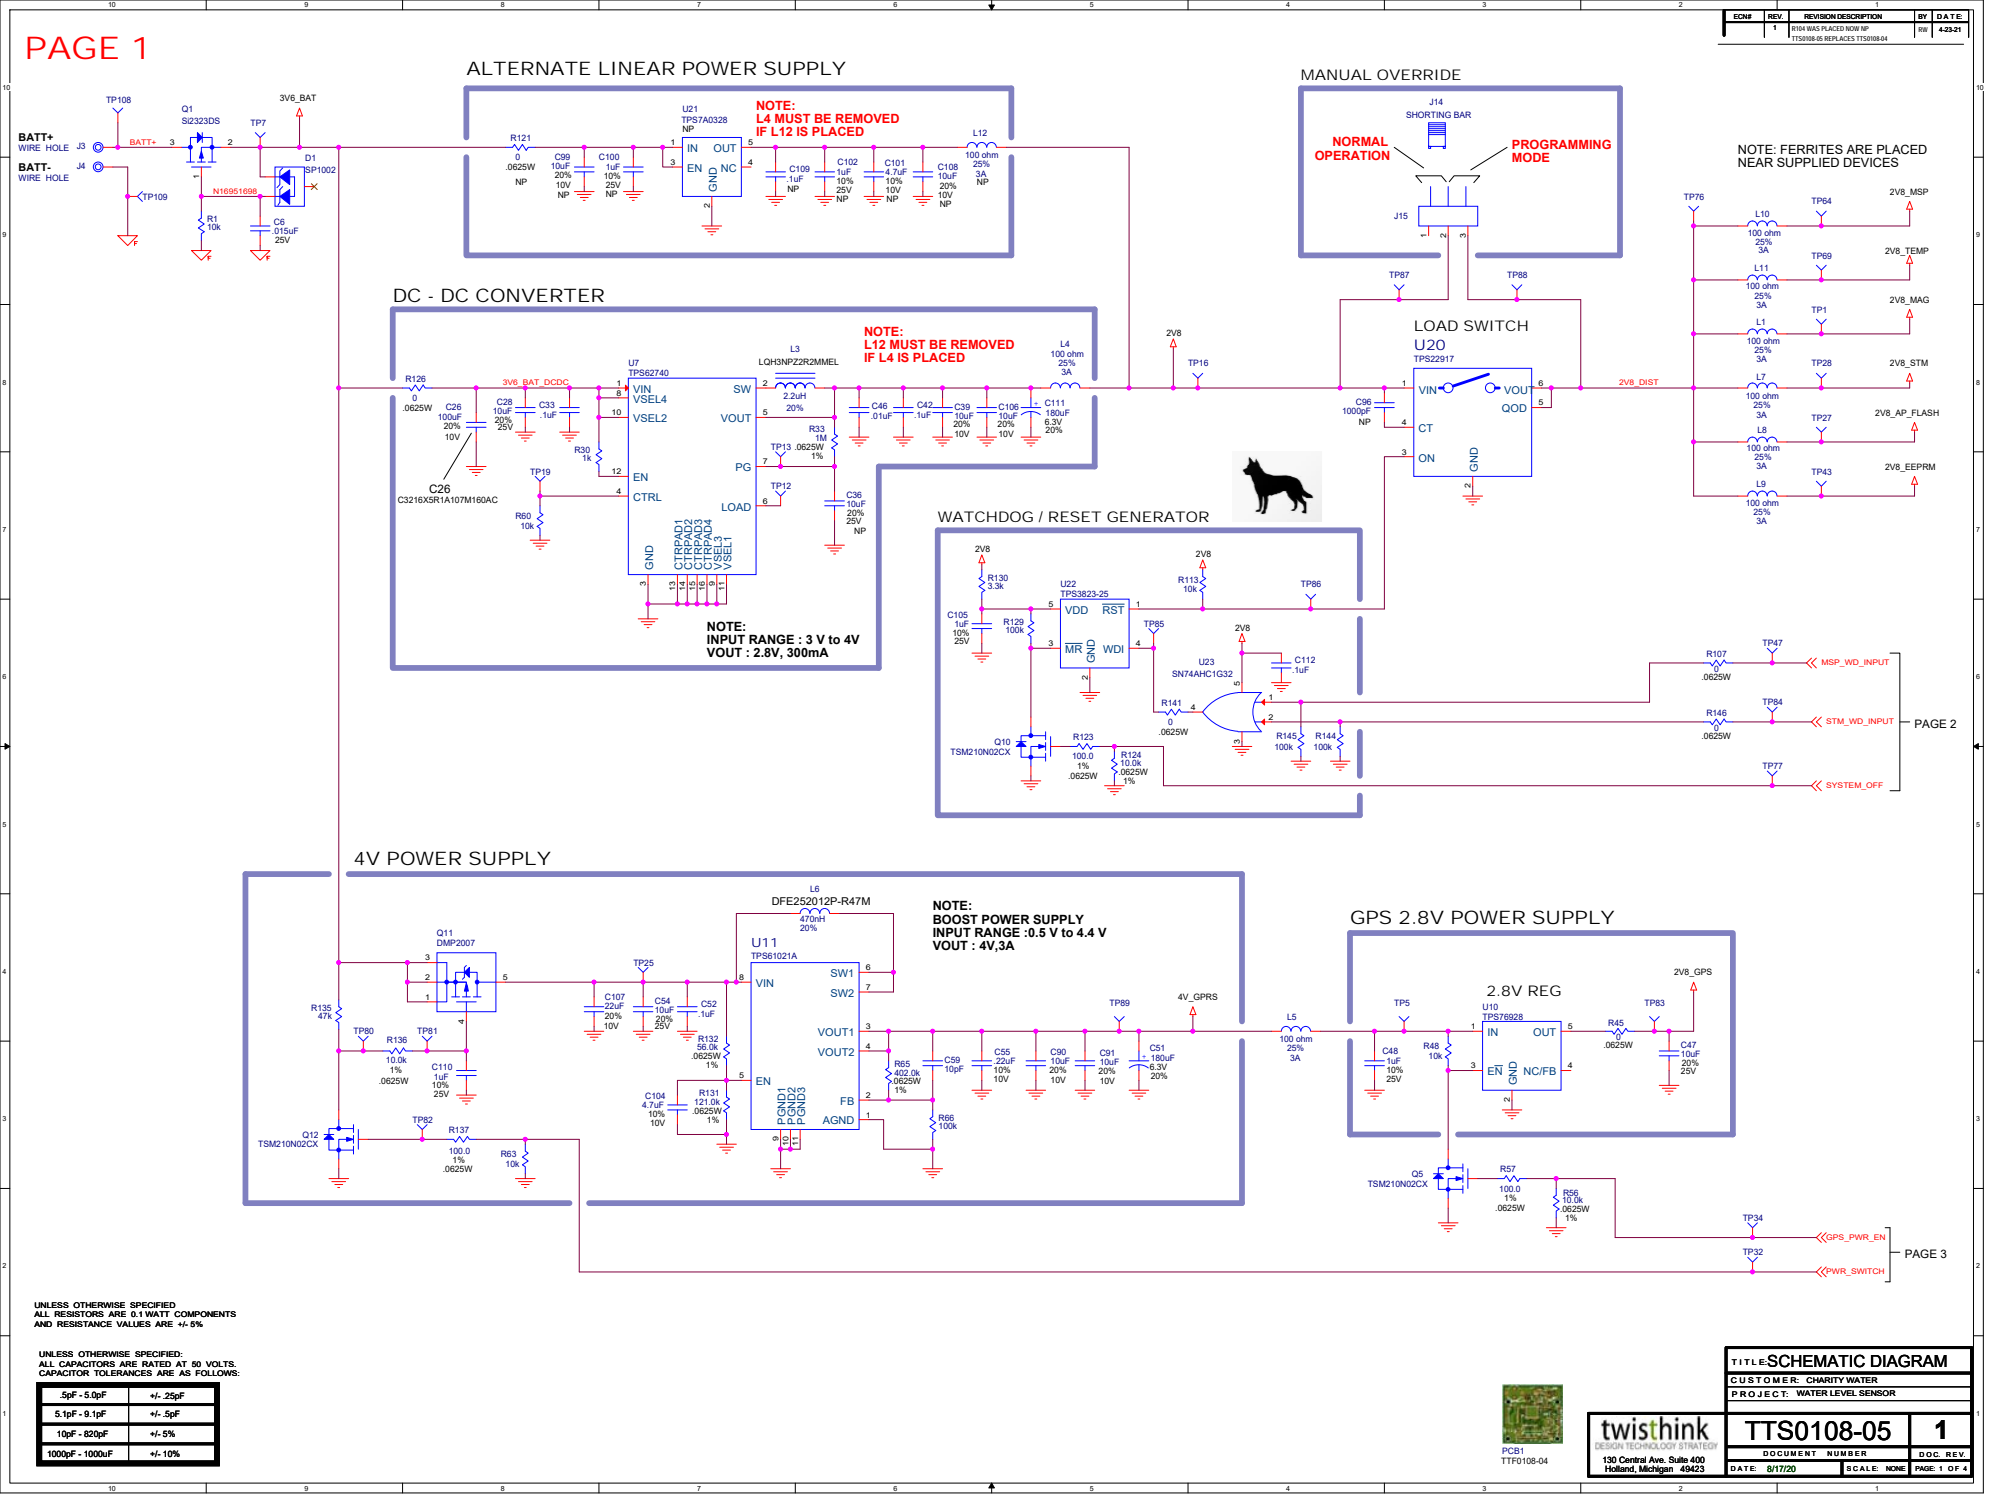
[picture p13: page 1]

R104 WAS PLACED NOW NP
TTS0108-05 REPLACES TTS0108-04

ALTERNATE LINEAR POWER SUPPLY

NOTE: FERRITES ARE PLACED
NEAR SUPPLIED DEVICES

UNLESS OTHERWISE SPECIFIED
ALL RESISTORS ARE 0.1 WATT COMPONENTS
AND RESISTANCE VALUES ARE +/- 5%

UNLESS OTHERWISE SPECIFIED:
ALL CAPACITORS ARE RATED AT 50 VOLTS.
CAPACITOR TOLERANCES ARE AS FOLLOWS:

130 Central Ave. Suite 400 130 Central Ave. Suite 400 130 Central Ave. Suite 400 Holland, Michigan 49423 Holland, Michigan 49423 Holland, Michigan 49423 | TTS0108-05 | 1

# PAGE 2

### PAGE 4

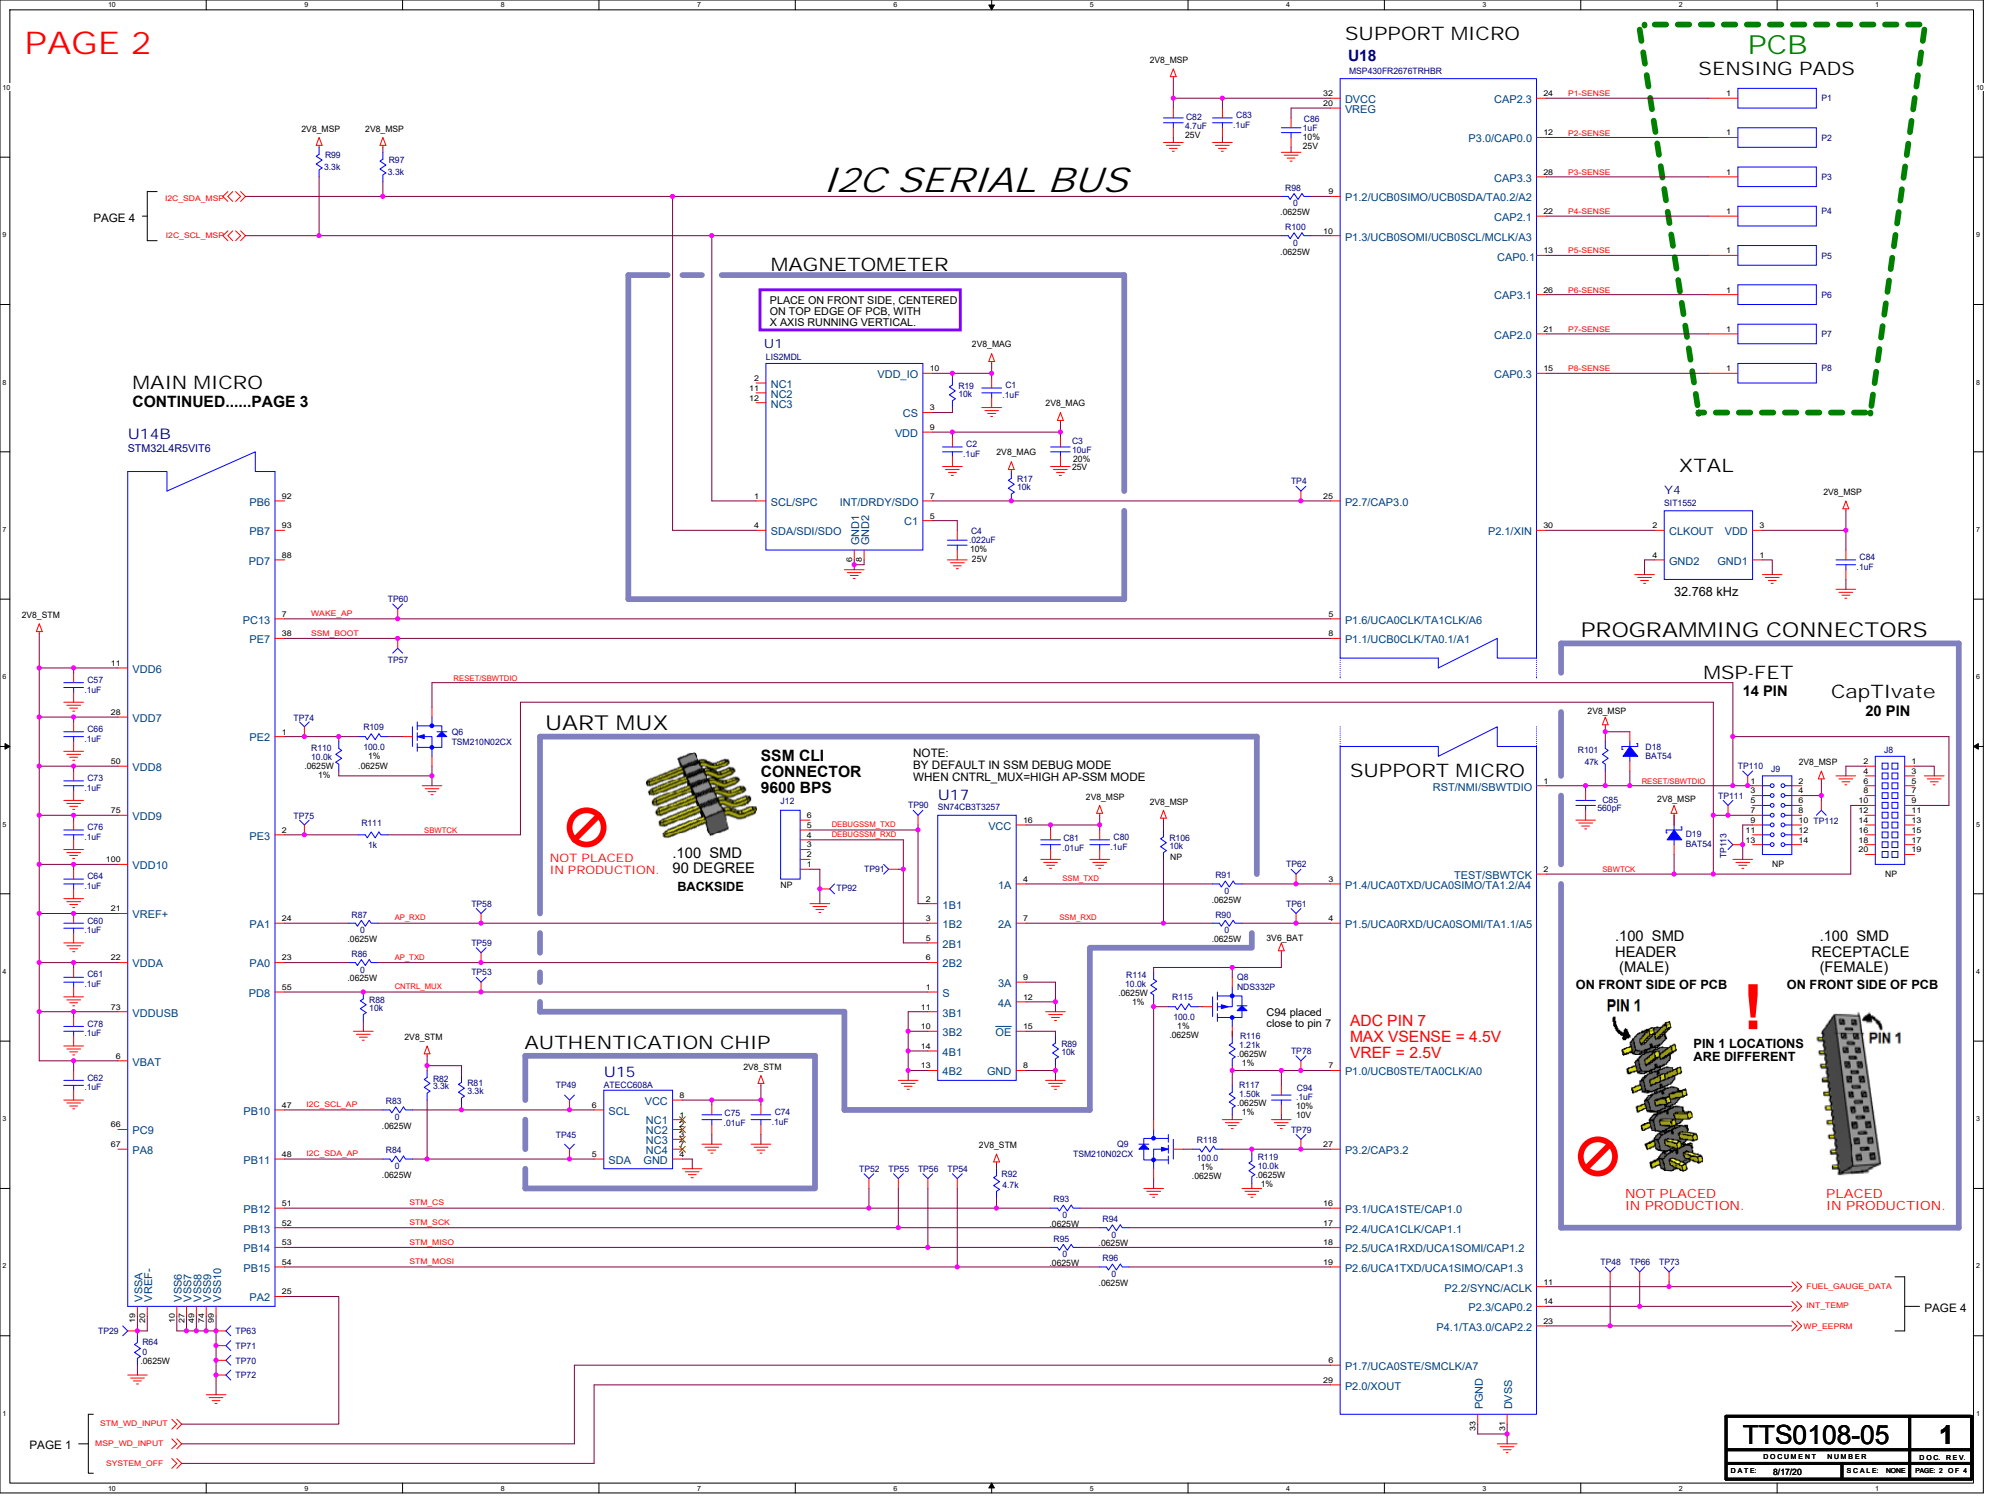
[picture p14: page 2]

PLACE ON FRONT SIDE, CENTERED
ON TOP EDGE OF PCB, WITH
X AXIS RUNNING VERTICAL.
LIS2MDL

NOTE:
BY DEFAULT IN SSM DEBUG MODE
WHEN CNTRL_MUX=HIGH AP-SSM MODE

.100 SMD
RECEPTACLE
(FEMALE)
ON FRONT SIDE OF PCB

# PAGE 3

# MAIN MICRO

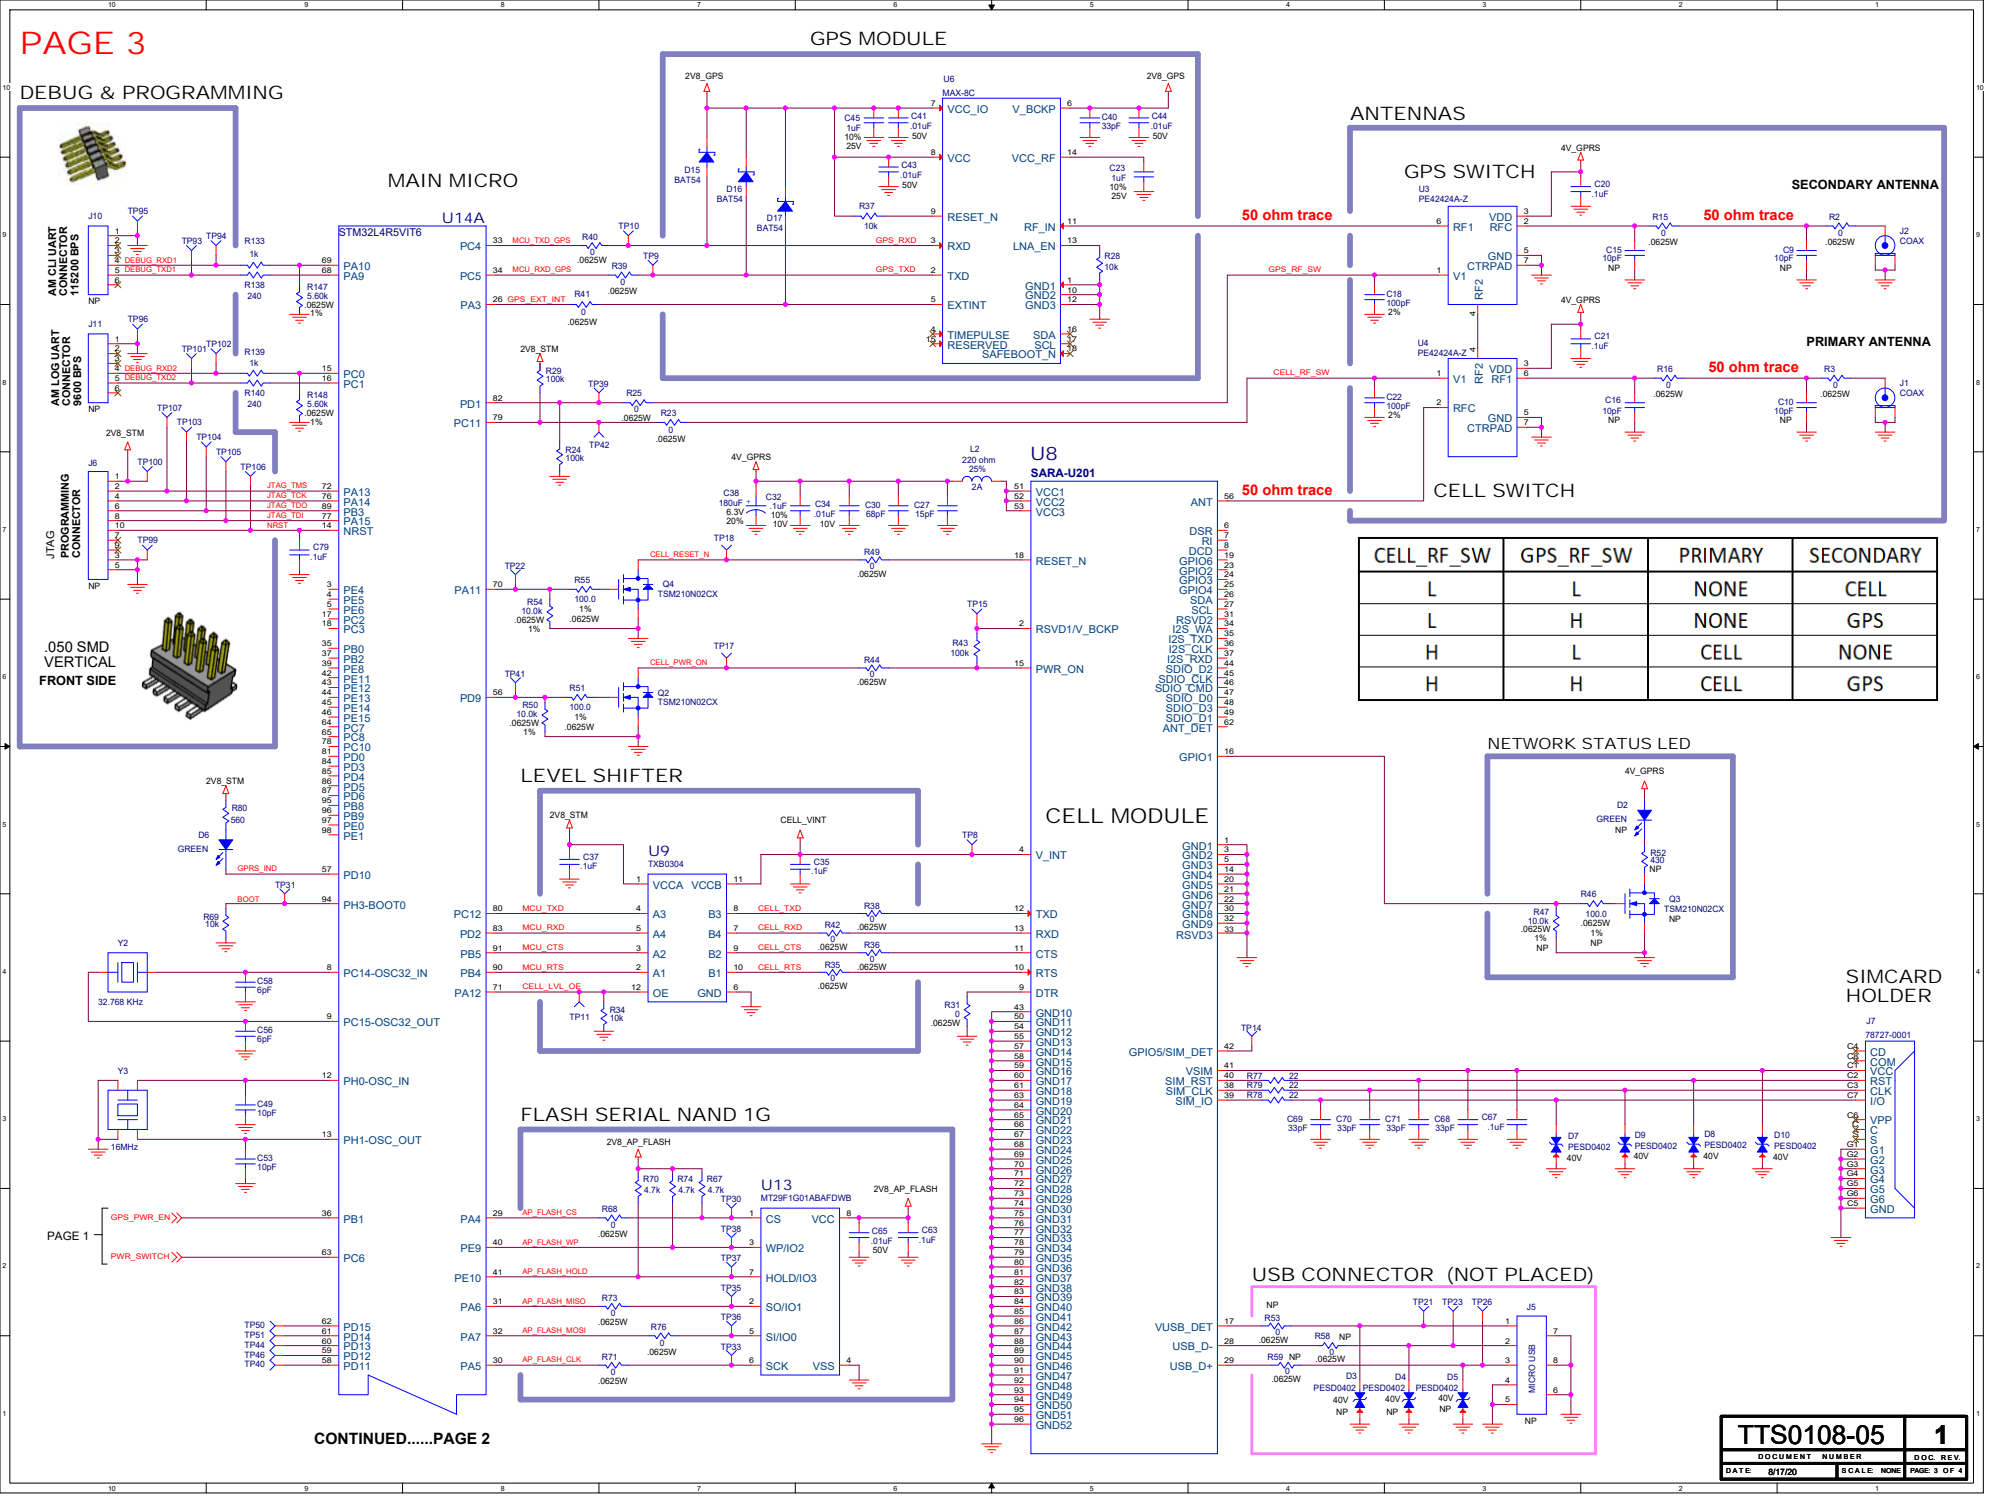
[picture p15: page 3]

USB CONNECTOR (NOT PLACED)

# REAL TIME CLOCK

# PAGE 4

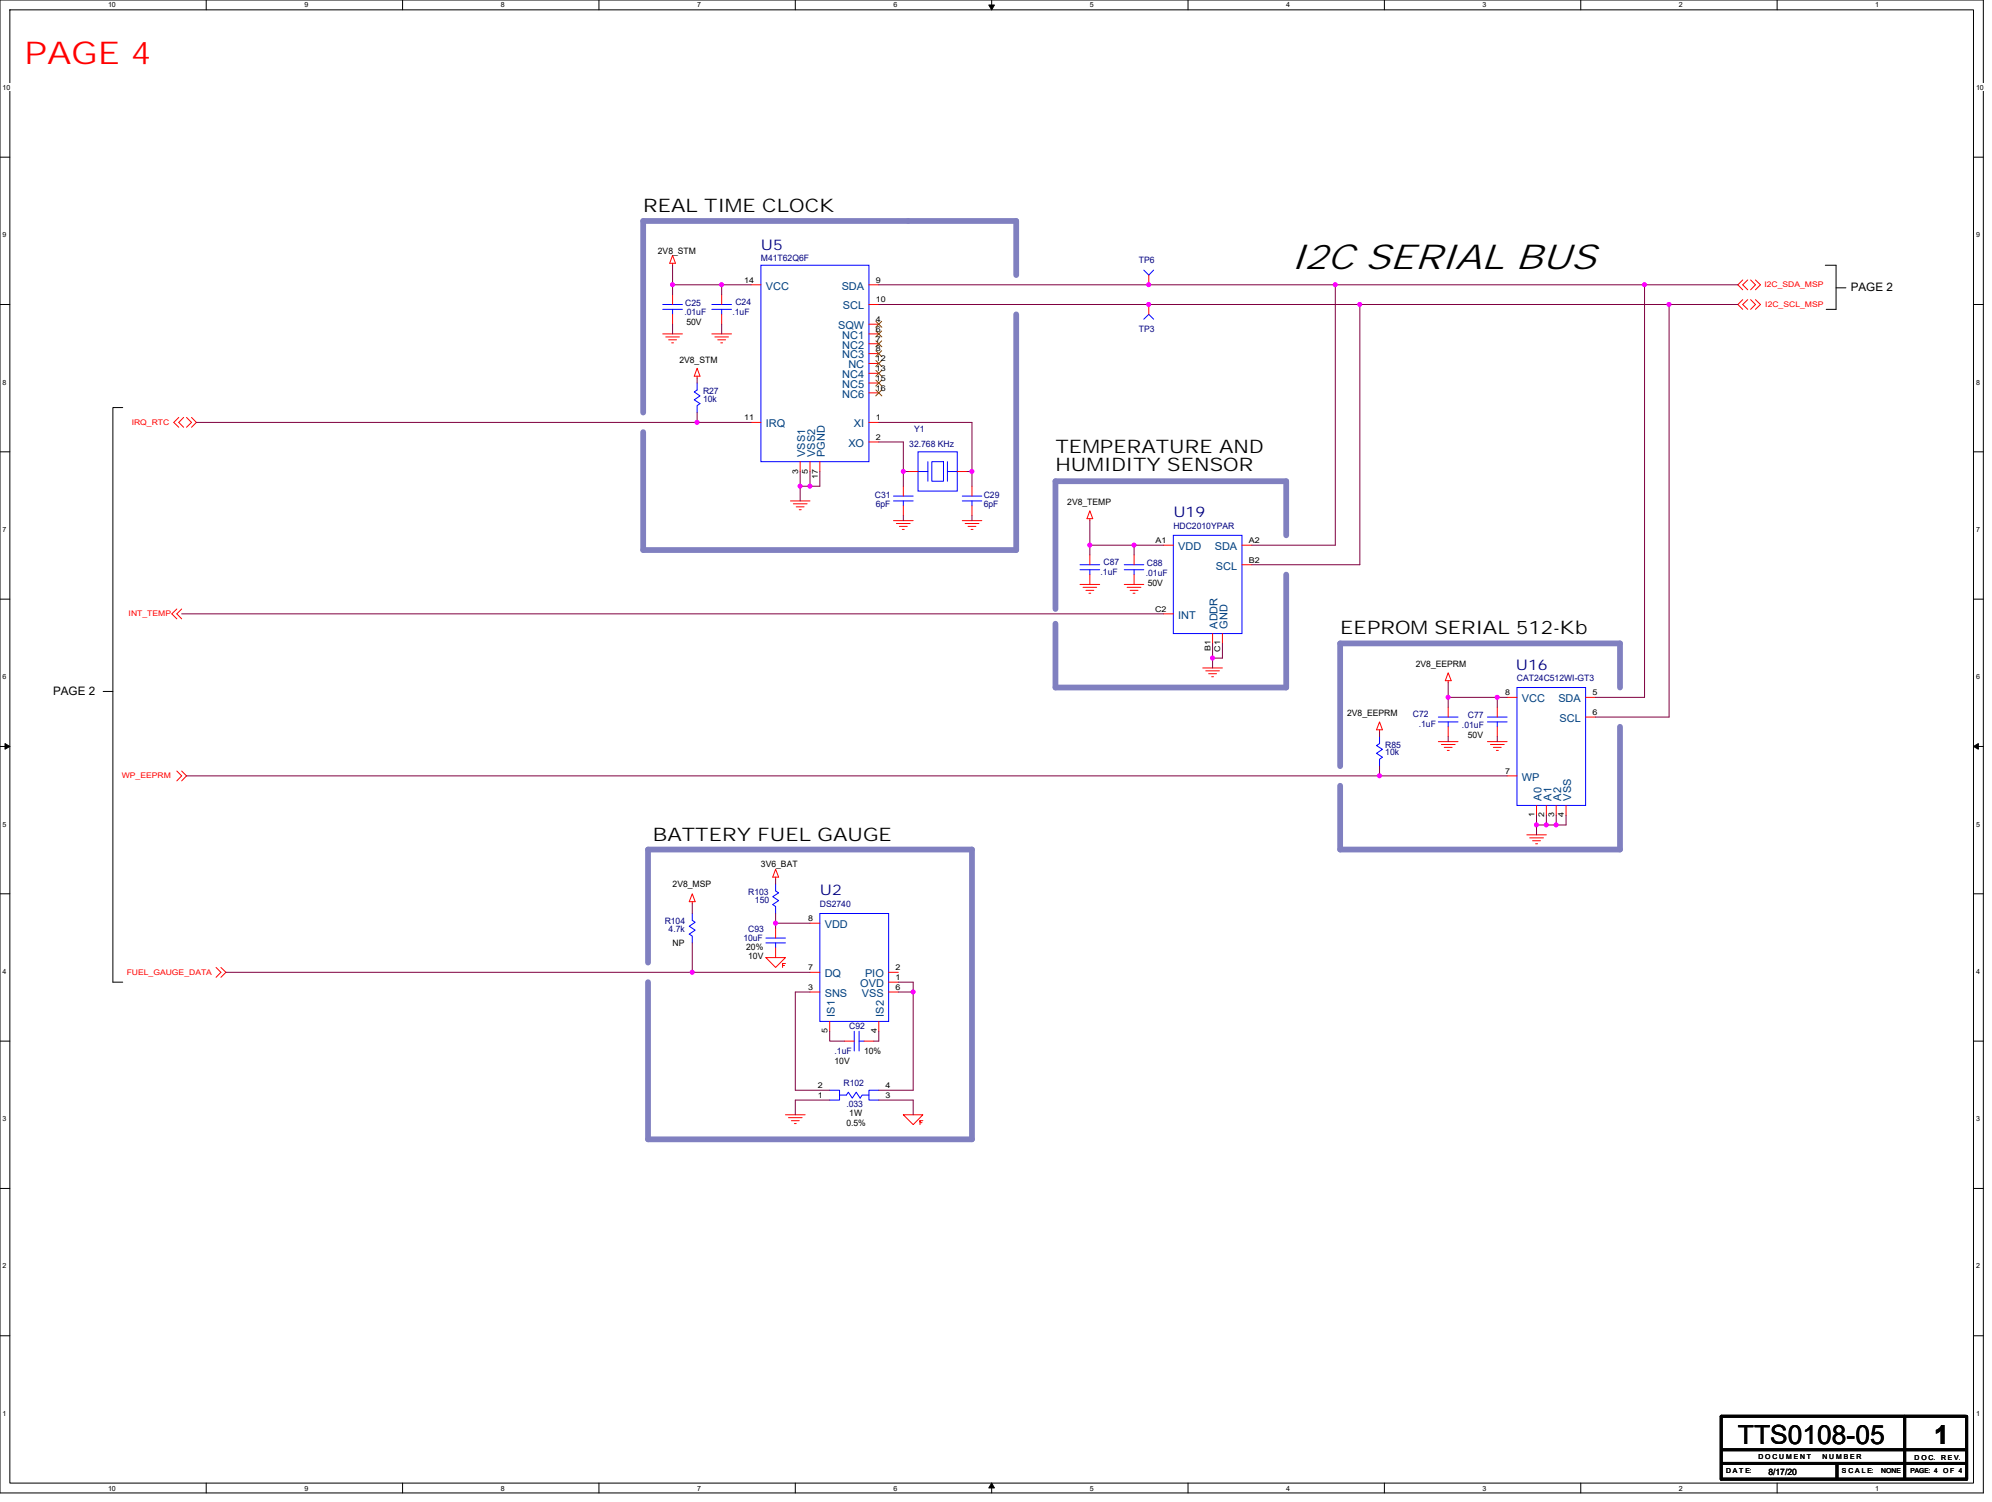
[picture p16: page 4]
