charitywater/india-mark-ii-sensor/Electrical/TTA0108_rev7.pdf

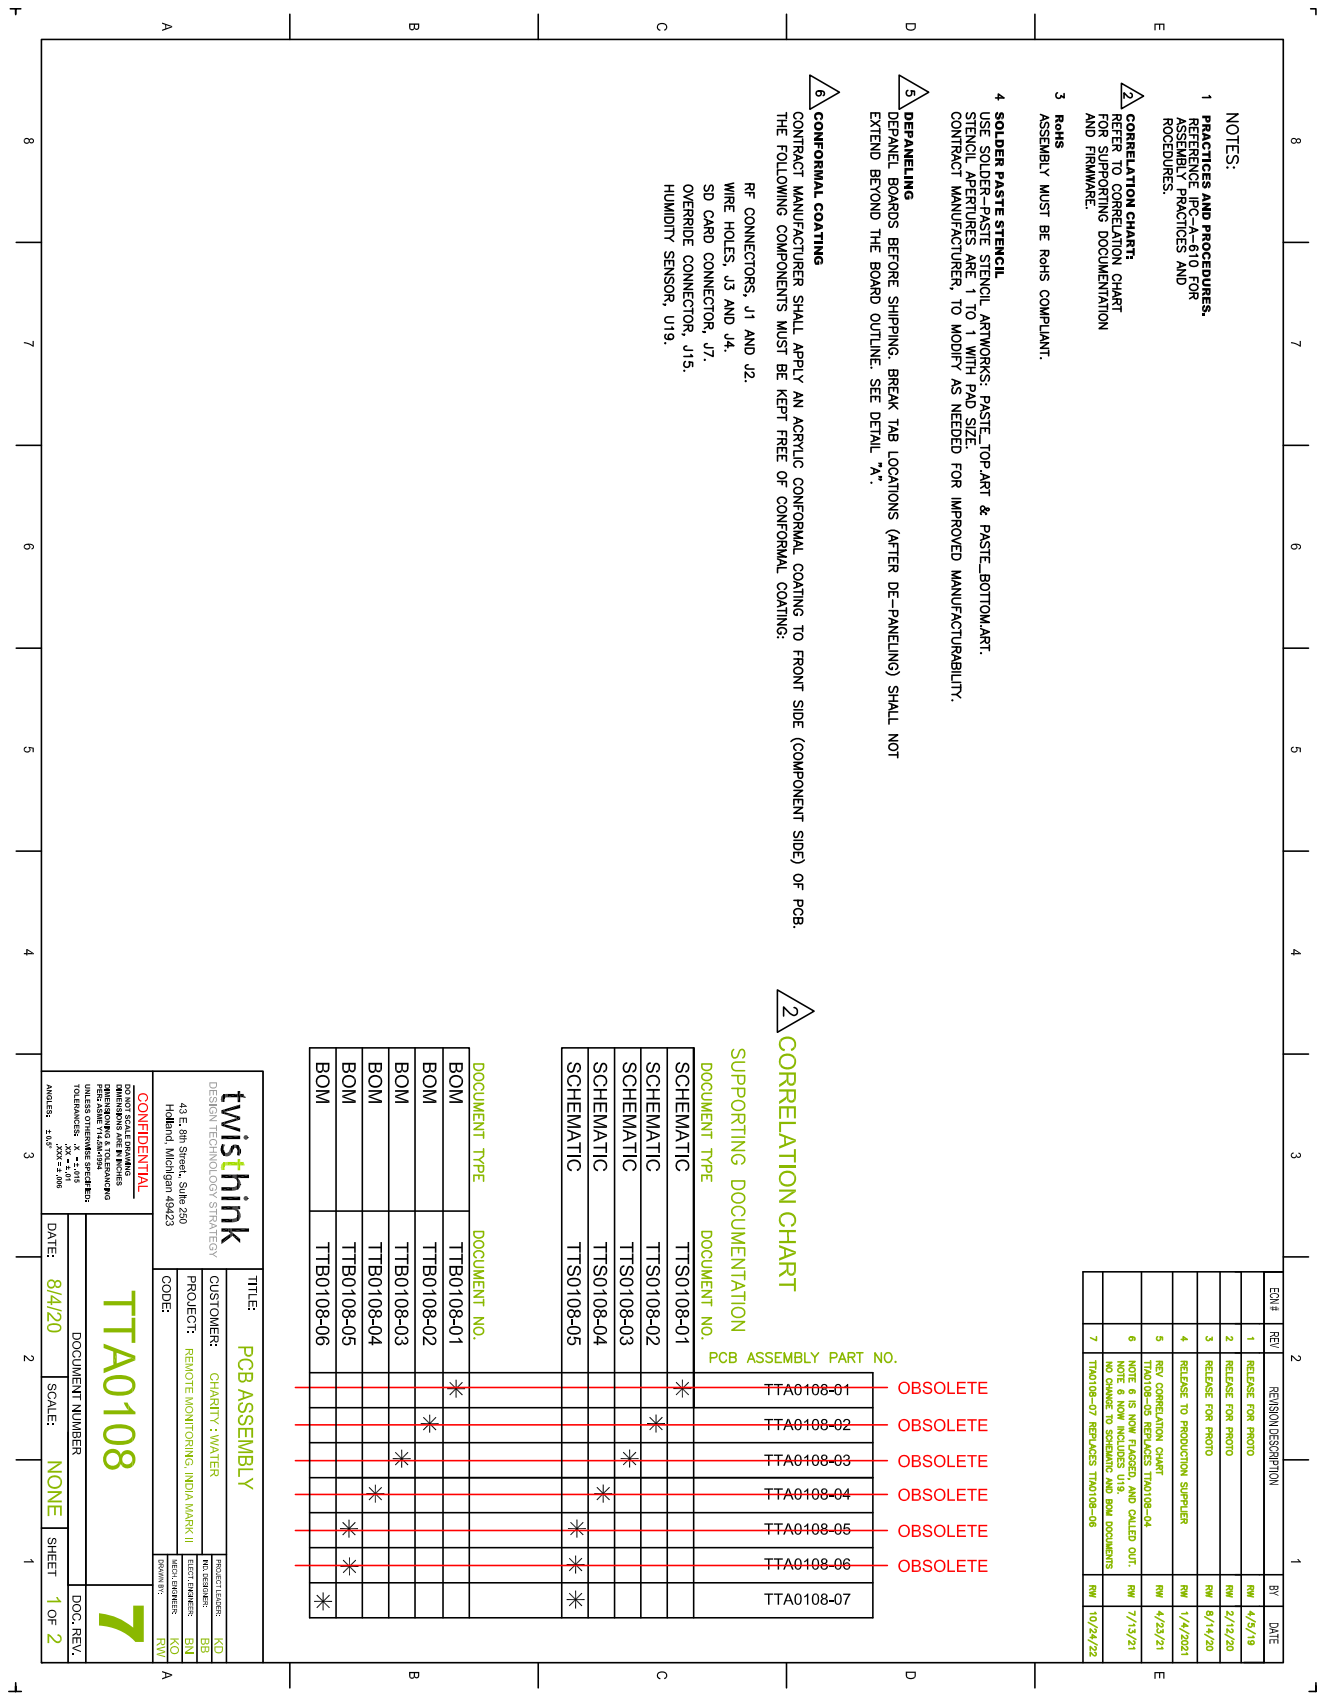
[picture p17: page 1]

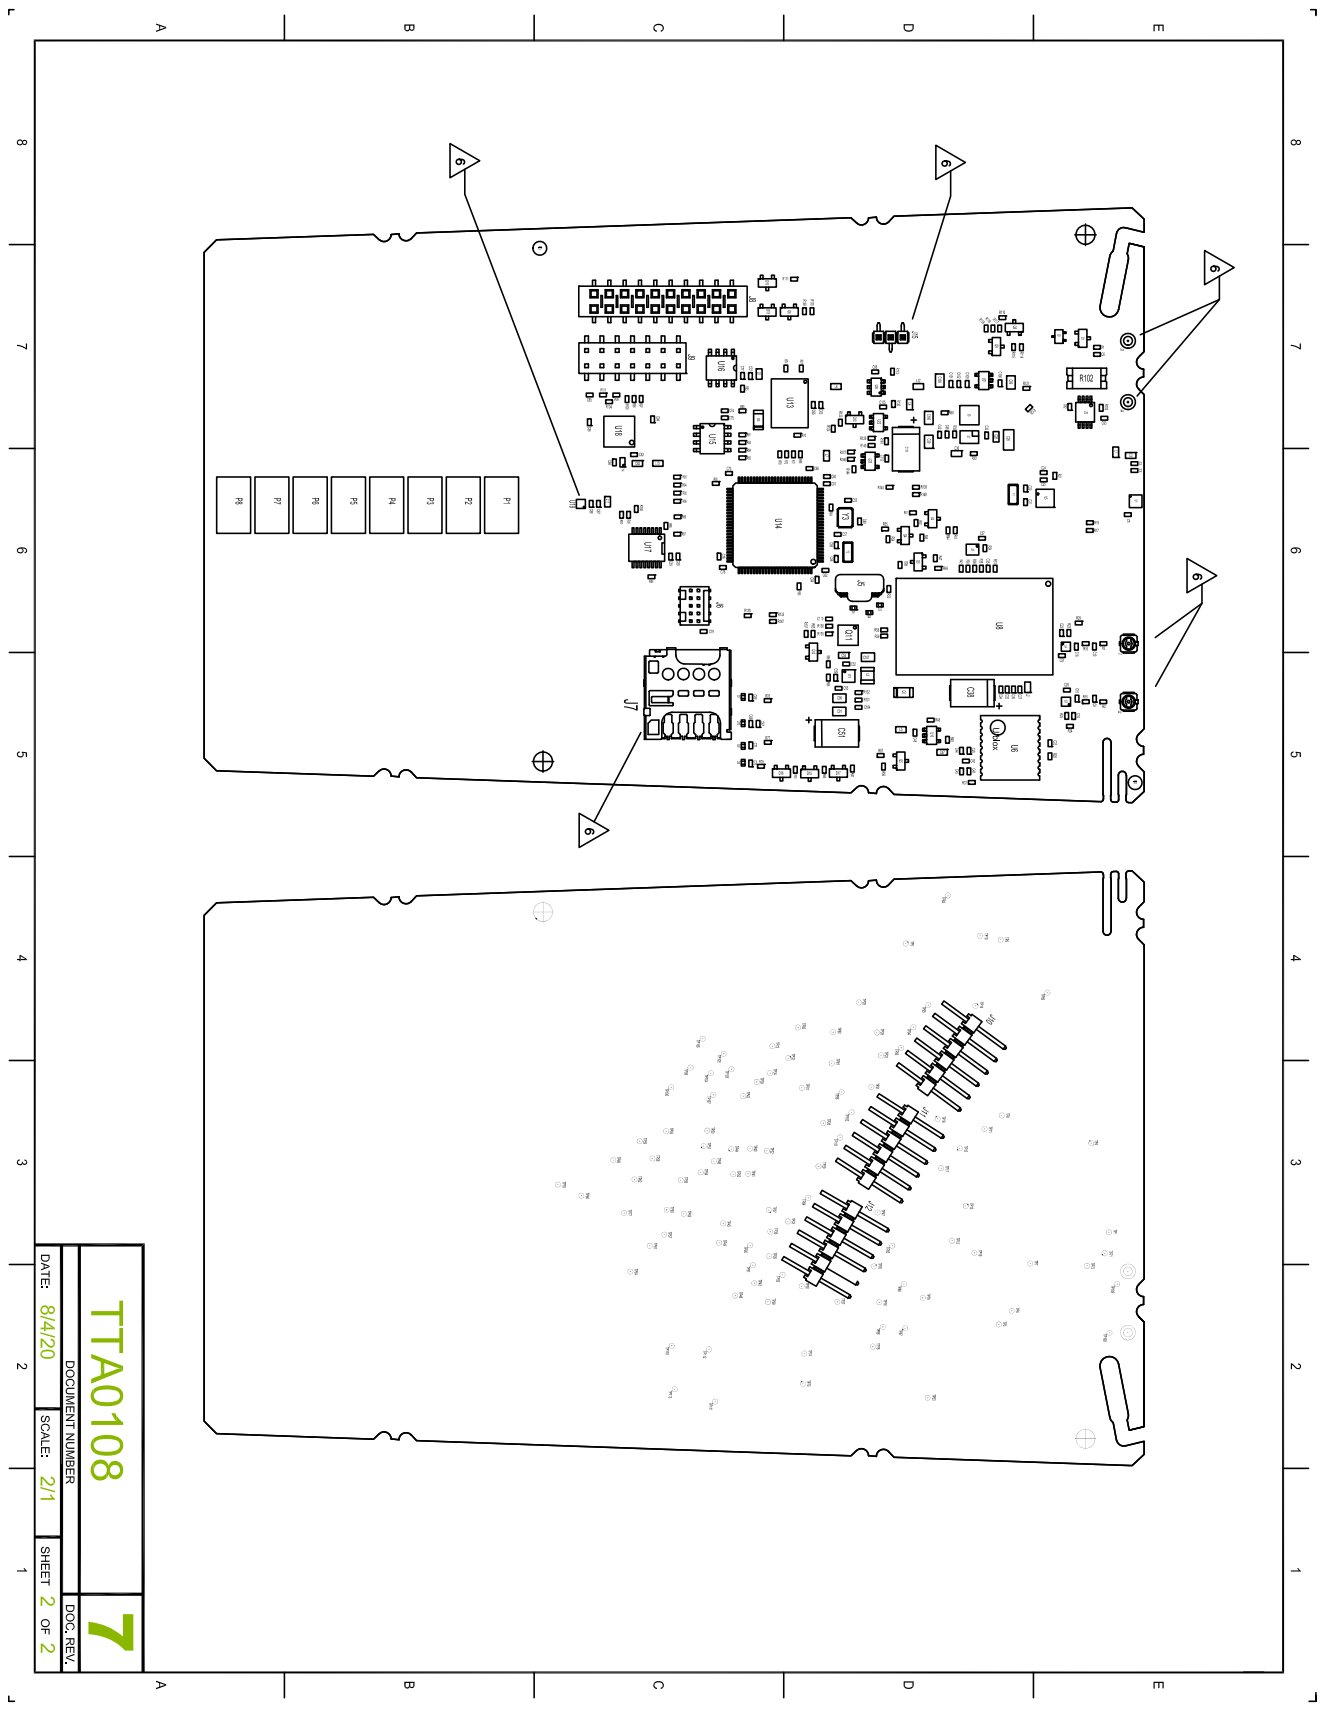
[picture p18: page 2]
