charitywater/india-mark-ii-sensor/Electrical/TTF0108_rev5.pdf

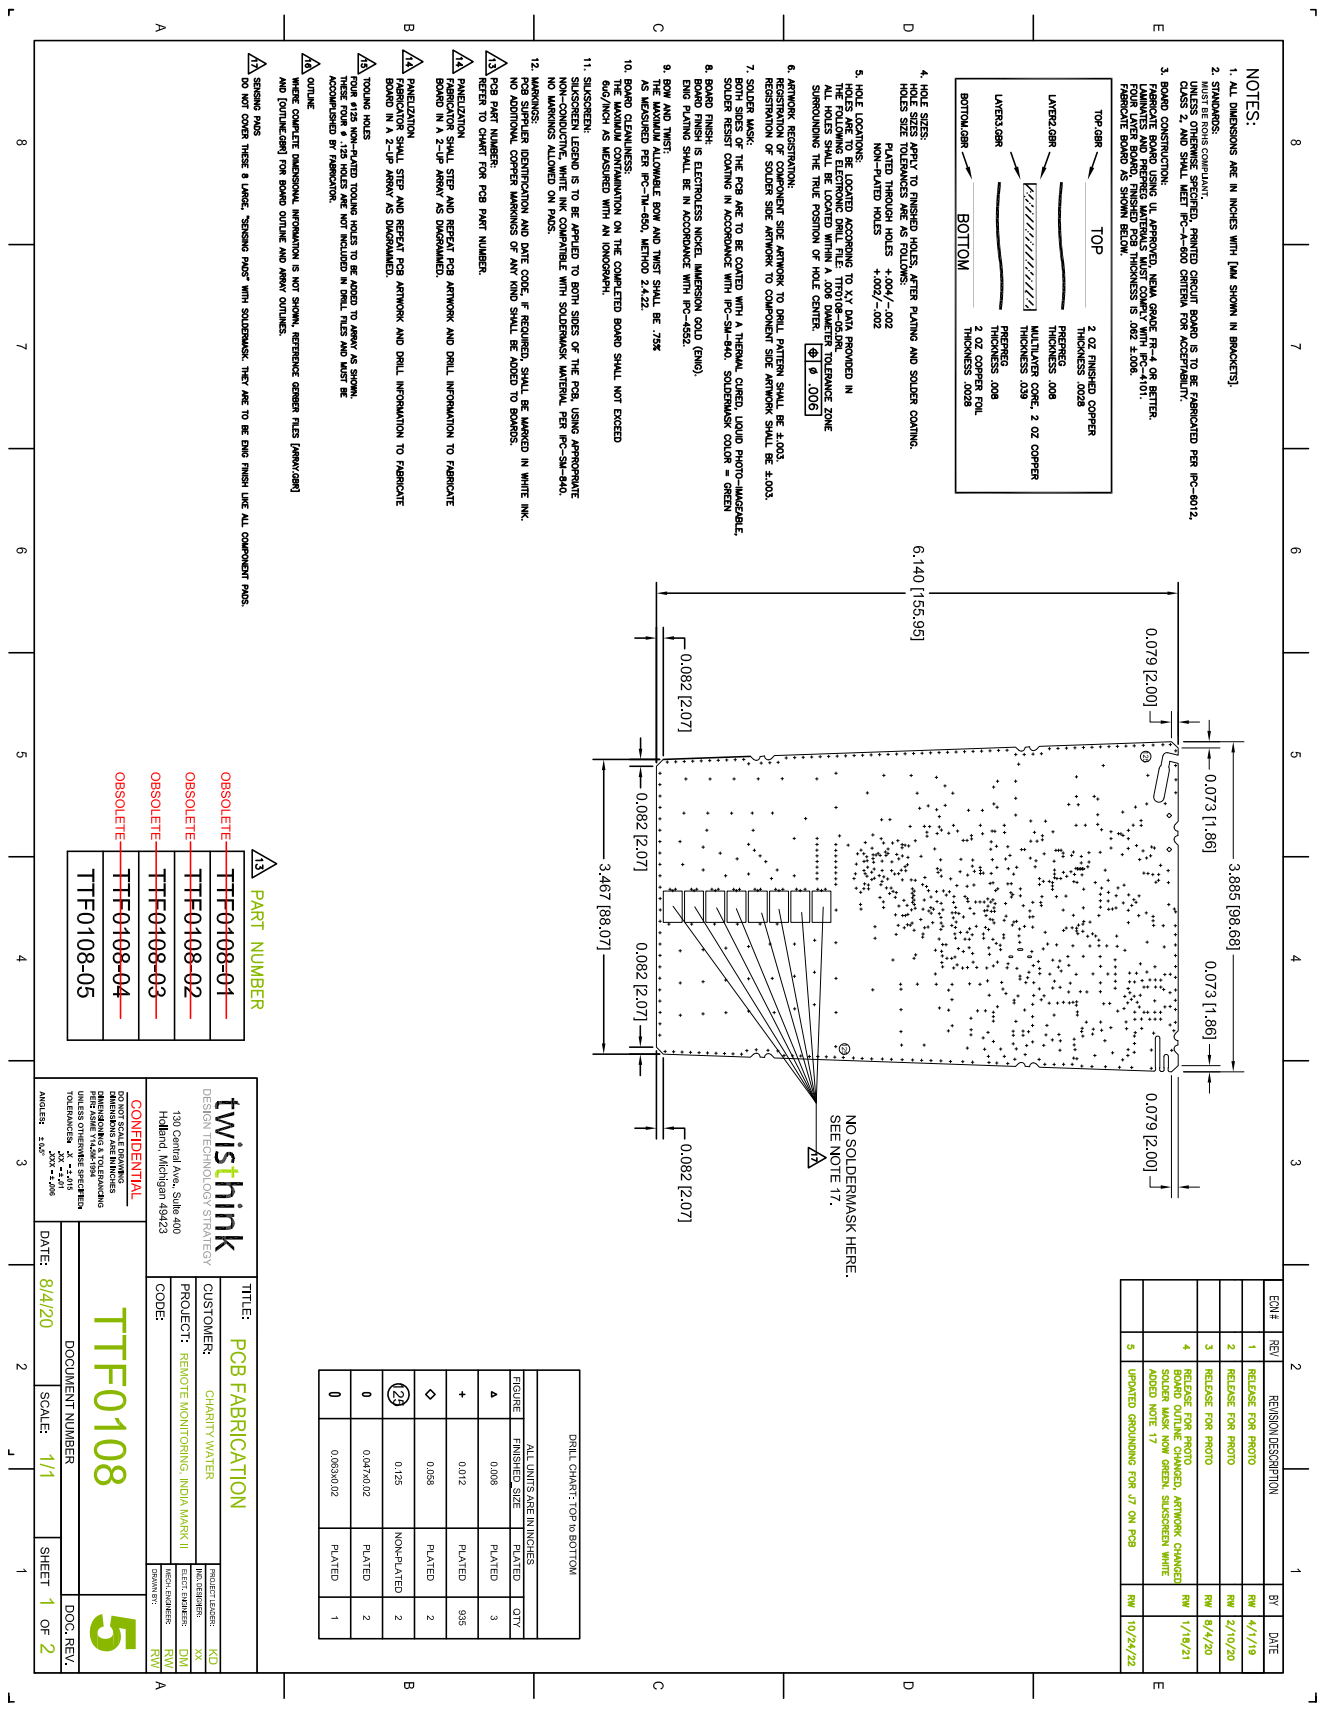
[picture p19: page 1]

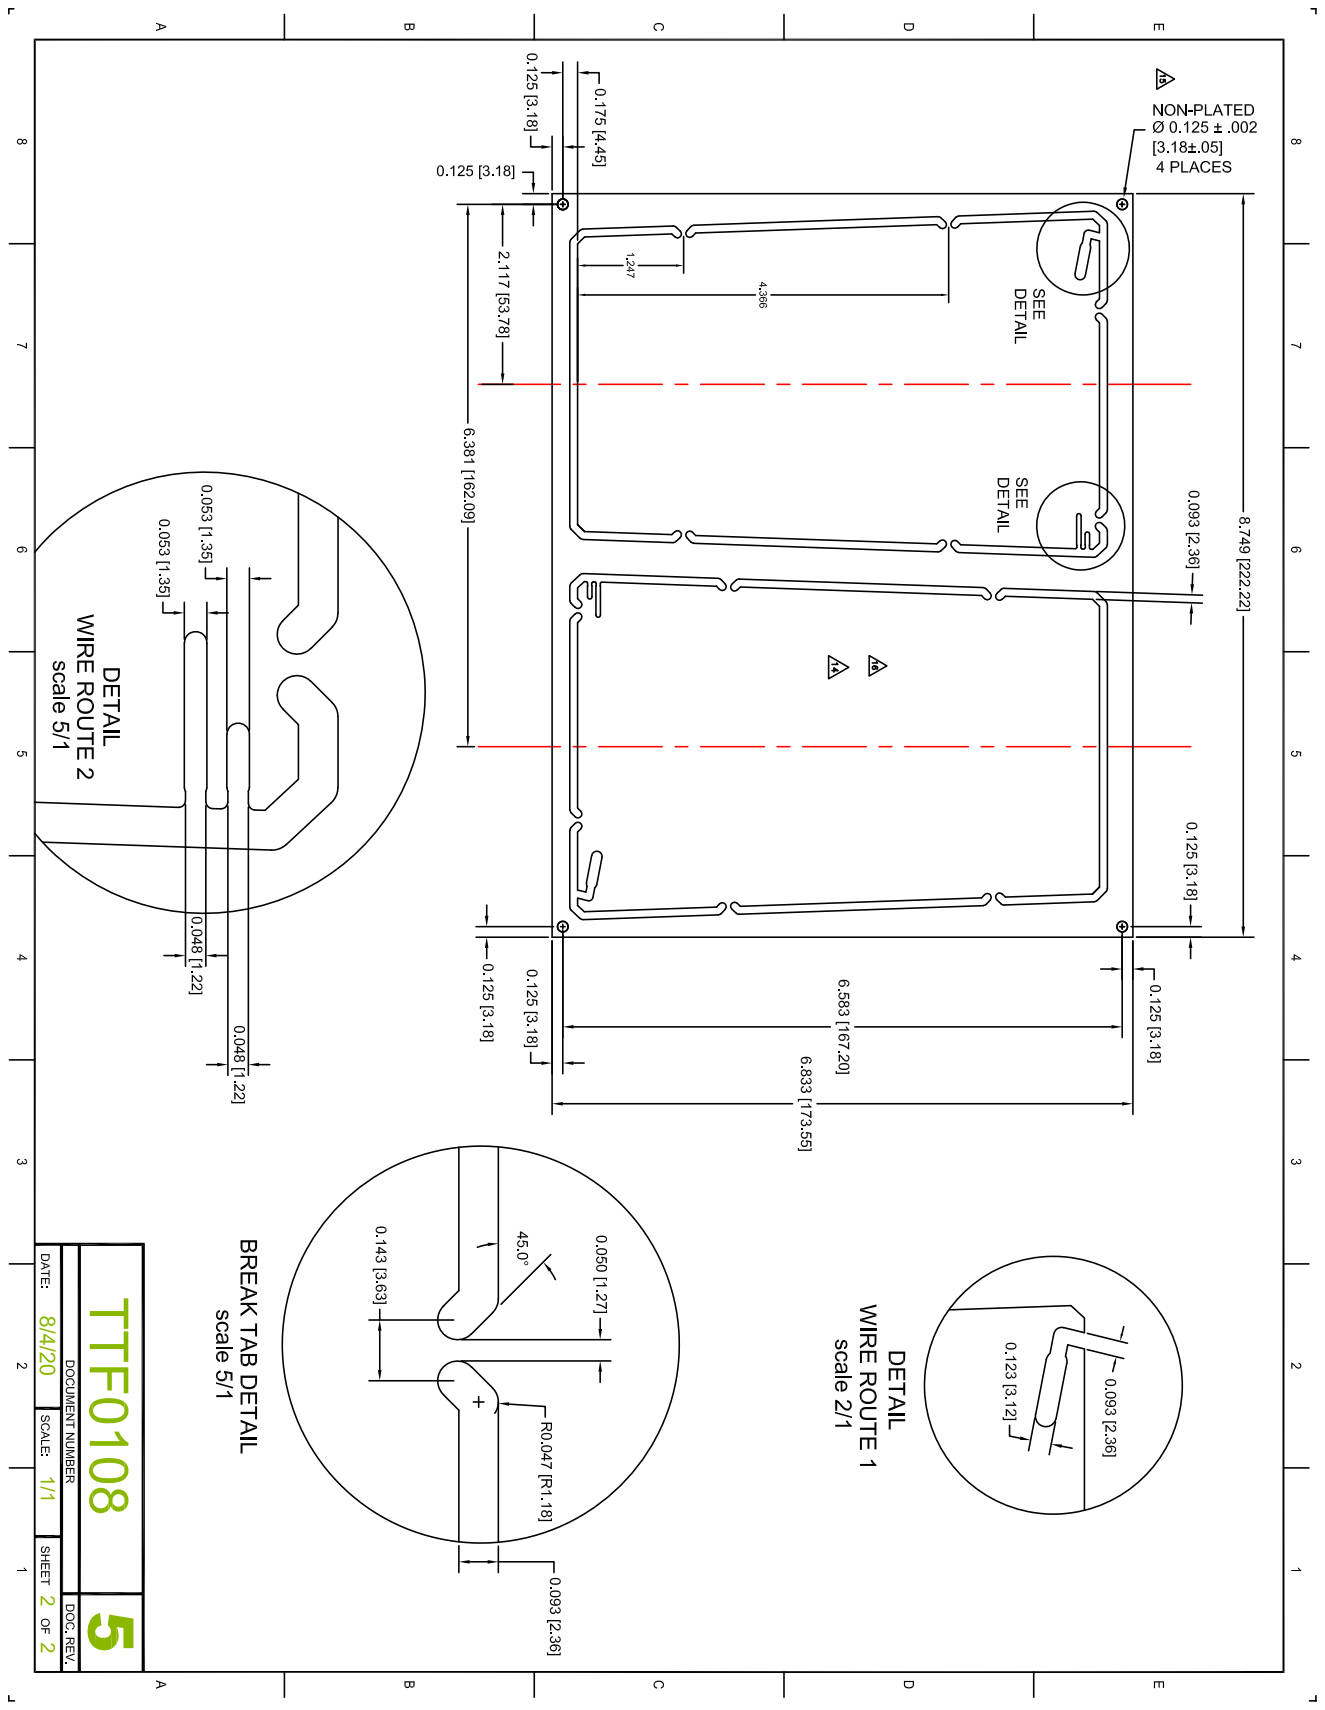
[picture p20: page 2]
