charitywater/india-mark-ii-sensor/Firmware/am/configuration/lwipopts.h

#define __LWIPOPTS_H__
#include "stdint.h"
#define PPP_SUPPORT       1
#define PPPOS_SUPPORT     1
#define PPP_SERVER        1
#define PPP_DEBUG         0
#define LWIP_ARP          0
#define PAP_SUPPORT       1
#define PPP_INPROC_IRQ_SAFE       1
#define PPP_NOTIFY_PHASE  1
#define MEMP_NUM_PPP_PCB  2
#define LWIP_COMPAT_MUTEX_ALLOWED  1
#define LWIP_DNS   1
#define LWIP_SO_SNDTIMEO   1
#define LWIP_SO_RCVTIMEO   1
#define LWIP_SO_SNDRCVTIMEO_NONSTANDARD   1
#define LWIP_SO_RCVRCVTIMEO_NONSTANDARD   1
#define LWIP_TCP_KEEPALIVE                  1
#define LWIP_RANDOMIZE_INITIAL_LOCAL_PORTS  1
#define ETHARP_TRUST_IP_MAC     0
#define IP_REASSEMBLY           0
#define IP_FRAG                 0
#define ARP_QUEUEING            0
#define TCP_LISTEN_BACKLOG      1
#define NO_SYS                 0
#define LWIP_ALLOW_MEM_FREE_FROM_OTHER_CONTEXT 1
#define LWIP_TCPIP_CORE_LOCKING_INPUT   1
#define LWIP_TCPIP_CORE_LOCKING         1
#define SYS_LIGHTWEIGHT_PROT            1
#define MEM_ALIGNMENT           4
#define MEM_SIZE                (10 *1024)
#define MEMP_NUM_PBUF           10
#define MEMP_NUM_UDP_PCB        2
#define MEMP_NUM_TCP_PCB        2
#define MEMP_NUM_RAW_PCB                2
#define MEMP_NUM_TCP_PCB_LISTEN 0
#define MEMP_NUM_TCP_SEG        12
#define MEMP_NUM_SYS_TIMEOUT    10
#define PBUF_POOL_SIZE          12
#define PBUF_POOL_BUFSIZE       512
#define LWIP_TCP                1
#define TCP_TTL                 255
#define TCP_QUEUE_OOSEQ         0
#define TCP_MSS                 (1500 - 40)
#define TCP_SND_BUF             (4*TCP_MSS)
#define TCP_SND_QUEUELEN        (2* TCP_SND_BUF/TCP_MSS)
#define TCP_WND                 (2*TCP_MSS)
#define TCP_MSL 6000UL
#define LWIP_SO_RCVTIMEO                1
#define LWIP_ICMP                       1
#define LWIP_RAW                        1
#define DEFAULT_RAW_RECVMBOX_SIZE       3
#define LWIP_DHCP               0
#define LWIP_UDP                1
#define UDP_TTL                 255
#define LWIP_STATS 0
#define LWIP_NETIF_LINK_CALLBACK        1
#define CHECKSUM_BY_HARDWARE           0
#if (CHECKSUM_BY_HARDWARE == 1)
#define CHECKSUM_GEN_IP                 0
#define CHECKSUM_GEN_UDP                0
#define CHECKSUM_GEN_TCP                0
#define CHECKSUM_CHECK_IP               0
#define CHECKSUM_CHECK_UDP              0
#define CHECKSUM_CHECK_TCP              0
#define CHECKSUM_GEN_ICMP               0
#else
#define CHECKSUM_GEN_IP                 1
#define CHECKSUM_GEN_UDP                1
#define CHECKSUM_GEN_TCP                1
#define CHECKSUM_CHECK_IP               1
#define CHECKSUM_CHECK_UDP              1
#define CHECKSUM_CHECK_TCP              1
#define CHECKSUM_GEN_ICMP               1
#endif
#define LWIP_NETCONN                    1
#define LWIP_SOCKET                     1
#define TCPIP_THREAD_NAME              "TCP/IP"
#define TCPIP_THREAD_STACKSIZE          512
#define TCPIP_MBOX_SIZE                 10
#define DEFAULT_UDP_RECVMBOX_SIZE       16
#define DEFAULT_TCP_RECVMBOX_SIZE       16
#define DEFAULT_ACCEPTMBOX_SIZE         16
#define DEFAULT_THREAD_STACKSIZE        384
#define LWIP_COMPAT_MUTEX               1
#if !defined(socklen_t) && !defined(SOCKLEN_T_DEFINED)
typedef int32_t socklen_t;
#define SOCKLEN_T_DEFINED (1)
#endif
