charitywater/india-mark-ii-sensor/Firmware/am/configuration/iot_pkcs11_config.h

/*
 * FreeRTOS V1.4.8
 * Copyright (C) 2020 Amazon.com, Inc. or its affiliates.  All Rights Reserved.
 *
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
 * http://aws.amazon.com/freertos
 * http://www.FreeRTOS.org
 */

/**
 * @file aws_pkcs11_config.h
 * @brief PCKS#11 config options.
 */


#ifndef _AWS_PKCS11_CONFIG_H_
#define _AWS_PKCS11_CONFIG_H_


/* A non-standard version of C_INITIALIZE should be used by this port. */
/* #define pkcs11configC_INITIALIZE_ALT */

/**
 * @brief PKCS #11 default user PIN.
 *
 * The PKCS #11 standard specifies the presence of a user PIN. That feature is
 * sensible for applications that have an interactive user interface and memory
 * protections. However, since typical microcontroller applications lack one or
 * both of those, the user PIN is assumed to be used herein for interoperability
 * purposes only, and not as a security feature.
 */
#define configPKCS11_DEFAULT_USER_PIN    "00112233445566778899AABBCCDDEEFF00112233445566778899AABBCCDDEEFF"

/**
 * @brief Maximum length (in characters) for a PKCS #11 CKA_LABEL
 * attribute.
 */
#define pkcs11configMAX_LABEL_LENGTH     32

/**
 * @brief Maximum number of token objects that can be stored
 * by the PKCS #11 module.
 */
#define pkcs11configMAX_NUM_OBJECTS      6

/**
 * @brief Set to 1 if a PAL destroy object is implemented.
 *
 * If set to 0, no PAL destroy object is implemented, and this functionality
 * is implemented in the common PKCS #11 layer.
 */
#define pkcs11configPAL_DESTROY_SUPPORTED                  0

/**
 * @brief Set to 1 if OTA image verification via PKCS #11 module is supported.
 *
 * If set to 0, OTA code signing certificate is built in via
 * aws_ota_codesigner_certificate.h.
 */
#define pkcs11configOTA_SUPPORTED                          0


// SET THIS TO 1 IF USING HARDCODED KEYS OR PROVISIONING THE CRYPTO
// DEVICE WITH NEW KEYS
#define pkcs11configIMPORT_PRIVATE_KEYS_SUPPORTED          0

/**
 * @brief Set to 1 if PAL supports storage for JITP certificate,
 * code verify certificate, and trusted server root certificate.
 *
 * If set to 0, PAL does not support storage mechanism for these, and
 * they are accessed via headers compiled into the code.
 */
#define pkcs11configJITP_CODEVERIFY_ROOT_CERT_SUPPORTED    0

/**
 * @brief The PKCS #11 label for device private key.
 *
 * Private key for connection to AWS IoT endpoint.  The corresponding
 * public key should be registered with the AWS IoT endpoint.
 */
#define pkcs11configLABEL_DEVICE_PRIVATE_KEY_FOR_TLS       "Device Priv TLS Key"

/**
 * @brief The PKCS #11 label for device public key.
 *
 * The public key corresponding to pkcs11configLABEL_DEVICE_PRIVATE_KEY_FOR_TLS.
 */
#define pkcs11configLABEL_DEVICE_PUBLIC_KEY_FOR_TLS        "Device Pub TLS Key"

/**
 * @brief The PKCS #11 label for the device certificate.
 *
 * Device certificate corresponding to pkcs11configLABEL_DEVICE_PRIVATE_KEY_FOR_TLS.
 */
#define pkcs11configLABEL_DEVICE_CERTIFICATE_FOR_TLS       "Device Cert"

/**
 * @brief The PKCS #11 label for the object to be used for code verification.
 *
 * Used by over-the-air update code to verify an incoming signed image.
 */
#define pkcs11configLABEL_CODE_VERIFICATION_KEY            "Code Verify Key"

/**
 * @brief The PKCS #11 label for Just-In-Time-Provisioning.
 *
 * The certificate corresponding to the issuer of the device certificate
 * (pkcs11configLABEL_DEVICE_CERTIFICATE_FOR_TLS) when using the JITR or
 * JITP flow.
 */
#define pkcs11configLABEL_JITP_CERTIFICATE                 "JITP Cert"

/**
 * @brief The PKCS #11 label for the AWS Trusted Root Certificate.
 *
 * @see aws_default_root_certificates.h
 */
#define pkcs11configLABEL_ROOT_CERTIFICATE                 "Root Cert"

#endif /* _AWS_PKCS11_CONFIG_H_ include guard. */
