charitywater/india-mark-ii-sensor/(commit log)

2021-05-25 Version 1.0.1 Commit
    [AM_FLASH_Mem_Map_v1.xlsx, Cap Map.xlsx, MCU_Connections.csv, SSM_EEPROM_Memory_Map_v1.xlsx, am-app Debug.cfg]
2022-02-07 Adding mechanical and electrical folders
    [AM_FLASH_Mem_Map_v1.xlsx, Cap Map.xlsx, MCU_Connections.csv, SSM_EEPROM_Memory_Map_v1.xlsx, am-app Debug.cfg]
