charitywater/india-mark-ii-sensor/(notices)

Notices in the files:
Firmware/am/configuration/lwipopts.h:
Copyright (c) 2001-2003 Swedish Institute of Computer Science.
All rights reserved.
